aadityaa0523/HridayMitra/source_code/docs/DECISIONS.md

# HridayMitra: where we started, what changed, and why

## 1. Initial ideas → final product

| Stage | Idea | What happened |
|---|---|---|
| First idea | Wrist band + SMS | Dropped: a wrist cannot measure fluid in the legs or chest; elders forget to charge and wear bands |
| Explored | Ankle band, toe ring, stole pendant | Toe ring rejected (not worn by men); pendant kept, as the amulet |
| Rejected by the team | Vest, smart pillow | "No one will wear a vest"; the pillow did not suit rural homes or shared beds |
| Locked | Foldable **check-in stool** (weight, 8-electrode impedance, finger PPG, voice, buttons, SIM800L) + **Kavach amulet** + **SMS care loop** | Satisfies every PS requirement under ₹5,000 |
| Build guide v1 → v3 | v2 added hand electrodes (chest by segmental subtraction) and the INA126; v3 cut cost (one HX711 bridge, voice from flash, no boot pins) | v3 is the build reference |

## 2. Decisions taken during the build (most recent last)

| # | Decision | Why | Evidence |
|---|---|---|---|
| 1 | Pretend patients built on a hidden "congestion" number, with every parameter marked as published / LTspice / ASSUMPTION | No human data allowed; every number must be traceable | `data/processed/DATA.md` |
| 2 | Guest days 3% → 1% | Weight rule gave 3× the published false-alert rate; calibrated to published results | `reports/calibration_check.csv` |
| 3 | Thresholds tuned on training patients only, then frozen | Honest testing; judges check this | `engine/frozen_params_v2.json` |
| 4 | Engine v2 (T = 7 → 6.5) | +9 points sensitivity at the same false alerts | `reports/leadtime_v2_results.csv` |
| 5 | No slow-drift (CUSUM) detector | Gave 5–7 days lead but 5× the false-alert budget | `reports/leadtime_v2_grid.csv` |
| 6 | Amber = patient-only "check again"; red = SMS | Amber gives 4 days' notice but fires 1–2× a month; only red should reach the family | `reports/amber_lead_results.csv` |
| 7 | ASHA always told at 2 h unless the family replies "fine" | First design left 14% of alerts never reviewed; now 6% | `reports/careloop_results.csv` |
| 8 | Care-loop ladder: family 1 → family 2 (30 min) → ASHA (2 h) → PHC doctor (6 h) | Best simulated result (92% reviewed before the visit); replaces the older product-brief version | `sim/careloop/careloop.py` |
| 9 | **R8/R9 bias resistors 1 MΩ → 10 MΩ** | Monte Carlo of 100 cheap-part stools: 1 MΩ gave up to 12% error and an unusable chest reading; 10 MΩ: 99% within 2% | `sim/circuit/montecarlo.py` |
| 10 | Firmware reads impedance with a Goertzel filter, never peak-to-peak; measure on battery | Mains hum: peak-to-peak 18% wrong with a charger; Goertzel ≤ 0.17% | `sim/circuit/hum.py` |
| 11 | Toe-ring / plate check in the engine (> 25% jump → "no reading") | LTspice showed a ring bridging plates reads 58–86% high | `tests/test_alert_engine.py` |
| 12 | Amulet radio: **Bluetooth Low Energy**, summary in the advertisement (no pairing) | Built into both ESP32s (₹0), low power, works offline, nothing to pair for elders | `firmware/hridaymitra_amulet/` |
| 13 | Cost counted as build cost only (no shipping) | Team decision | `tools/cost_sim.py` |
| 14 | Engine runs **on the ESP32** (C++ port), the laptop only logs and shows | PS demands offline operation; proven identical to Python (100% of 3,231 days) | `tests/test_engine_parity.py` |
| 15 | "No check-in today" now holds yesterday's light; new "still learning" state for the first ~10 days | Found a gap: the no-data path never fired; cold start was silent | `engine/alert_engine.py` |
| 16 | Keep the rule engine, not machine learning, as the main decider | Logistic regression catches 6–12 points more but with 3–5× the false alarms; rules explain themselves and run in 7 KB | `reports/ml_comparator.csv` |
| 17 | Voice prompts from Windows' offline speech engine for now; recorded human clips override them | Gives working audio today; Hindi/Tamil need a human voice | `tools/make_voice_clips.py` |
| 18 | Missed days on the stool detected from the SIM800L network clock | No RTC on the board; keeps the history true | `clockNow()` in the stool firmware |
| 19 | **Product layer** around the engine (lights unchanged, so all frozen results stay valid): doctor's sick-day plan, coaching tips, two users per stool, daily self-test with service SMS, 11:00 missed check-in reminder, Sunday ASHA summary, village dashboard, OPD report, ABDM/FHIR export | Another team also built a chair; the difference has to be the product around it | `engine/product.py`, `tests/test_product.py`, firmware `duties()` |
| 20 | Seat vibration motor on GPIO19 (₹40) and tablet-drawer switch on GPIO36 (₹25); AD8232 LO− dropped to free GPIO36 | Hearing loss is common in elders; medicine adherence is measured instead of asked. Build cost now ₹4,243–4,397 | `tools/make_schematic.py` (ERC 0), build guide v3 section 4 |
| 21 | Battery level and signal strength read from the SIM800L (AT+CBC, AT+CSQ) | No free analog pin needed for the self-test | `selfTest()` |
| 32 | **Sit-to-stand from the platform's force** (the chair now stands on the weighing platform, so the weight never leaves it): the force above / below body weight is the body's vertical acceleration; integrated twice it is the rise itself. A minimum-jerk rise + slow drift is fitted (start, duration, height); not a stand if the height is outside 0.12-0.65 m or the fit is poor. No new parts | Synthetic rises (different motion model: skewed, forward-lean dip, sway, HX711 noise, 10 S/s), 40-100 kg, 1-4.5 s: 100 % found, median error 0.14 s (0.07 s fast, 0.16 s slow), 0 false stands while seated; C++ = Python; firmware emulator 2.20 s for a 2.2 s rise | `engine/sts.py`, `tests/test_sts.py`, `hm::stsFit` |
| 31 | **Hybrid engine: rules propose, ML confirms** (`engine/hybrid.py`): rules at T 4.0, a logistic model (13 weights, trained on dev only) must agree before red; SpO2 danger always red; reasons stay the rules' | Benchmark v2, frozen before testing: caught 86 % on test, external and stress (rules v3: 66 / 72 / 63 %, ML only: 80 / 81 / 77 %), false alerts 0.19 / 0.09 / 0.19 per patient-month (budget 0.21). Runs on the laptop and app; the stool still runs rules v3 | `benchmark/LEADERBOARD.md`, `tests/test_benchmark.py` |
| 30 | **Open benchmark v2** (`benchmark/`): fixed dev / test / external / stress splits with sha256, a public scorer with bootstrap ranges, 5 baselines, datasheet | Anyone can score a method the same way; our numbers are reproducible | `benchmark/README.md` |
| 29 | **Calibration against published trials**: FAST and SCALE-HF 1 weight rules applied exactly as defined | External cohort: 20 % caught vs 23 % published (FAST), 33 % vs 35 % (SCALE-HF 1); unexplained alerts 4.8 vs 4.3 and 4.85 vs 4.18 per patient-year. The 60-day PS cohort catches the same share but has ~7 false alerts per year (harsher than the trials) | `engine/calibrate_published.py` |
| 28 | **CHARGE / USE switch** (SW6, DPDT, +₹50): USE cuts both USB wires; CHARGE is sensed on GPIO39 (moved off the optional ECG LO+) and the firmware refuses to measure | Charger leakage through an earthed patient: 339 µA with a cheap charger (limit 100 µA), 72 mA with a failed one; with the switch on USE 0.19 µA in every case. Total still ₹4,820, ₹180 under the limit | `sim/circuit/charger_leakage.py`, `tests/sil`, `tools/make_schematic.py` netlist checks |
| 27 | **6-minute walk test on the amulet** (no new parts): steps from the walking rhythm (autocorrelation of 5 s windows at 20 Hz), best 6 minutes in the last 24 h sent over BLE; the stool asks for the walk on Sundays and the weekly SMS gives steps, ~metres (STEP_LENGTH_M, set once over 10 m) and last week. Reported to the ASHA/doctor, **not** in the alert score: it has no validated weight yet, and adding it would change the frozen engine | Synthetic: snug cord within 2.7% at 60-120 steps/min and 0.05-0.3 g steps; loose cord within 4% at normal steps, up to 23% under with very light steps. 0 false steps in 30 min each of sitting, fidgeting, auto-rickshaw ride, turning in bed. C++ = Python | `engine/walk_accuracy.py`, `tests/test_walk.py`, `tests/sil` |
| 26 | **Self-calibrating reference**: R5 → 120 Ω + Rcal 100 Ω 0.1% (+₹10); the spare 74HC4053 switch on GPIO12 makes every reading relative to the precision resistor and checks the (R5 + Rcal)/Rcal = 2.2 ratio at each check-in | Monte Carlo absolute error median 0.77% → 0.16%, 99% of readings 1.96% → 1.32%. A damaged or wrongly built reference is caught and the stool sends a service SMS instead of numbers (firmware emulator) | `sim/circuit/selfcal.py`, `sim/circuit/montecarlo.py`, `tests/sil` |
| 25 | **Patient-safety fault analysis (IEC 60601-1, type BF)** before building | Every single fault passes with ≥ 12.8× margin (6.6× in normal use); the two series capacitors block DC. No circuit change needed; a "Charge / Use" switch is recommended | `sim/circuit/safety.py` |
| 24 | **Bioimpedance spectroscopy (5/20/50 kHz) + engine v3**: the legs are measured at three frequencies; an exact closed-form Cole fit on the ESP32 gives the share of water outside the cells; ADC streamed by DMA at 200 kS/s (analogRead is too slow for 50 kHz); C5 unchanged | LTspice: +10% fluid outside cells → index +3.0%, foot position/temperature +3% → index 0.0% (single-frequency reading +3.0%), fluid inside cells → index −2.9%. Engine v3 (threshold re-tuned on training patients, frozen at 7.0): external cohort 65% → 72% sensitivity at the same false alerts; held-out: same sensitivity, lead 2 → 3 days, false alerts 0.03 → 0.06 | `sim/circuit/spectroscopy.py`, `engine/bis.py`, `engine/tune_v3.py`, `reports/v3_results.csv` |
| 23 | **Wokwi with three custom chips**: virtual patient with an 8-electrode front end (sliders: leg/chest fluid, lifted foot, hum), MAX30102 (pulse, SpO₂, finger), SIM800L with a phone screen (replies, missed call, outage, battery) | Wokwi has none of these parts; judges can make the virtual patient sick and watch the real firmware react. Production firmware builds with `HM_WOKWI` (no BLE, 1 s = 1 min, 20 days preloaded) | `wokwi/`, `tools/make_wokwi.py` |
| 22 | **Software-in-the-loop proof**: the real firmware is compiled on a laptop against an emulated world (body impedance through the ADC, HX711 bits, MAX30102 FIFO, SIM800L AT commands, buttons, BLE, flash) and lives a scripted month | No boards yet; this proves the firmware's logic end to end. It found 3 real bugs, now fixed: user 1's usual weight started at 0 kg; a red day could pass with no SMS after an earlier red; user 1 was not recognised once a second user was enrolled. Also fixed a rare lost-reply race | `tests/sil/`, `tests/test_firmware_sil.py`, `reports/sil_run.log` |

## 3. Where it can still improve (after the hackathon)

1. **Bench build vs simulation**: build the resistor phantom and the stool, compare with LTspice (the biggest open risk).
2. **Real voices**: record Hindi and Tamil prompts (drop WAVs into `firmware/voice/hi/`, run `python tools/make_voice_clips.py --lang hi`).
3. **SpO₂ calibration** against a reference oximeter (the formula is generic).
4. **Hybrid engine**: add learned weights (logistic regression) inside the two-witness rules, aiming for its +6–12 points without its false alarms.
5. **Lead time**: a trend detector that respects the alert budget (the drift detector gave 5–7 days but too many alarms).
6. **A ₹100 real-time clock (DS3231)** so missed days are known even without network time.
7. **Amulet**: validate breathing and sit-up detection on a breathing phantom or recorded motion data; tune the fall threshold.
8. **Clinical pilot** (ethics-approved): compare the chest reading with lung ultrasound B-lines; refit the alert threshold on real data.
9. **Wokwi** simulation of the firmware's check-in flow (optional, for the demo).
10. **Hardware**: a printed circuit board from the KiCad schematic, stainless-steel plates, and a splash-proof enclosure.
