aadityaa0523/HridayMitra/source_code/docs/hardware/frontend_sheet.pdf

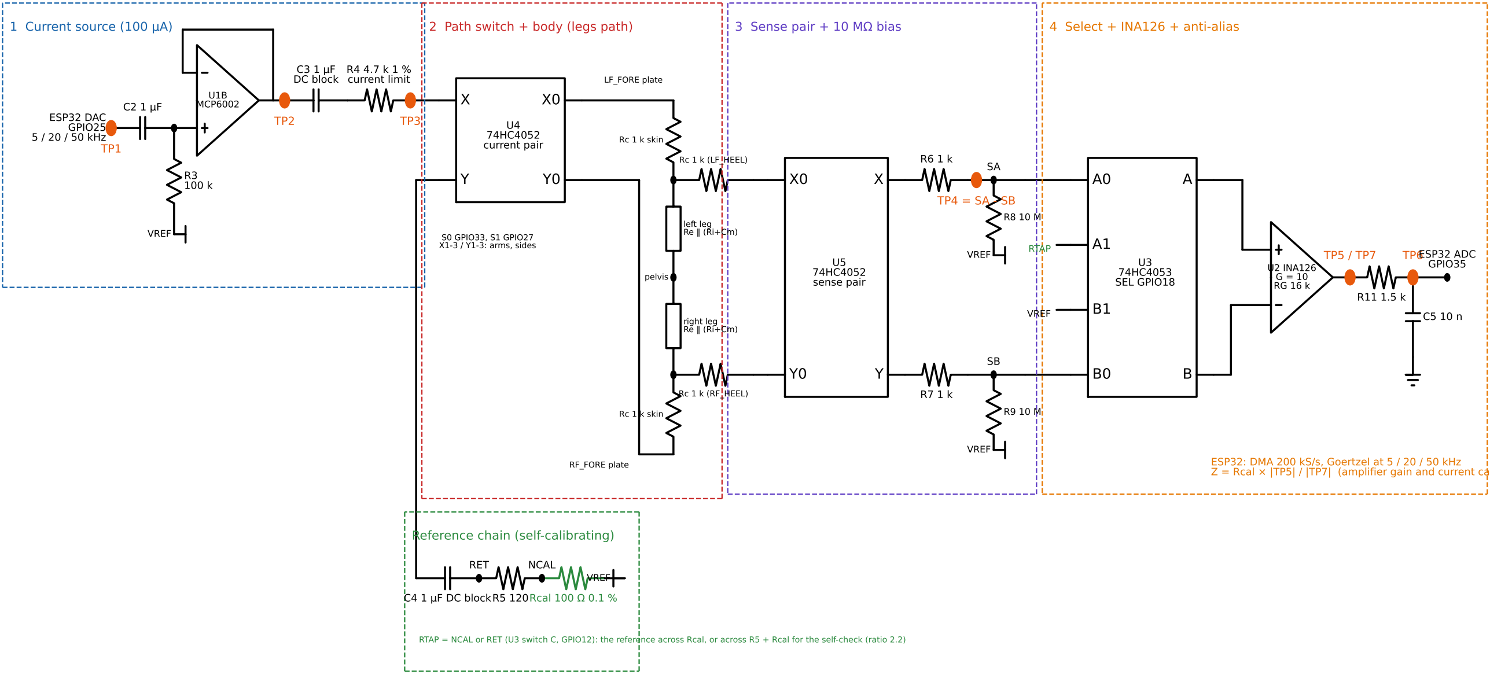
[picture p24: figure]
VREF; U1B MCP6002; C3 1 µF DC block; R4 4.7 k 1 % current limit; U4 74HC4052 current pair; S0 GPIO33, S1 GPIO27 X1-3 / Y1-3: arms, sides; LF_FORE plate; Rc 1 k skin; left leg; right leg; k skin; RF_FORE plate; C4 1 µF DC blockR5 120Rcal 100; Rc 1 k (LF_HEEL); Rc 1 k (RF_HEEL); U5 74HC4052 sense pair; U3 74HC4053 SEL GPIO18; RTAP; U2 INA126 G = 10 RG 16 k; Reference chain (self-calibrating); ESP32 DAC GPIO25 5 / 20 / 50 kHz TP1; pelvis; RET; NCAL; TP6ESP32 ADC; GPIO35

RTAP = NCAL or RET (U3 switch C, GPIO12): the reference across Rcal, or across R5 + Rcal for the self-check (ratio 2.2)

ESP32: DMA 200 kS/s, Goertzel at 5 / 20 / 50 kHz
Z = Rcal × |TP5| / |TP7| (amplifier gain and current cancel)
1 Current source (100 µA) | 2 Path switch + body (legs path)
3 Sense pair + 10 M bias | 4 Select + INA126 + anti-alias
Patient safety (IEC 60601-1 type BF, LTspice): C3 and C4 in series block DC; R4 limits the current; every single fault stays | 12.8× under the limit. CHARGE / USE switch (SW6) cuts both charger wires while measuring: leakage 0.19 µA instead of 339 µA.
0.0 | 0.5 | 1.0 | 1.5 | 2.0
ms

0.75

1.00

1.25

1.50

1.75

2.00

2.25

2.50

V

±0.83 V

TP1 DAC out

0.0 | 0.5 | 1.0 | 1.5 | 2.0
ms

0.75

1.00

1.25

1.50

1.75

2.00

2.25

2.50

V

±0.83 V

TP2 buffer out

0.0 | 0.5 | 1.0 | 1.5 | 2.0
ms

100

50

0

50

100

µA

±108 µA

TP3 current through the body

0.0 | 0.5 | 1.0 | 1.5 | 2.0
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
±62.3 mV

TP4 voltage across the legs

0.0 | 0.5 | 1.0 | 1.5 | 2.0
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
±0.623 V

TP5 INA126 out (body)

0.0 | 0.5 | 1.0 | 1.5 | 2.0
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
±0.564 V

TP6 ADC pin

0.0 | 0.5 | 1.0 | 1.5 | 2.0
ms

1.55

1.60

1.65

1.70

1.75

V

±0.108 V

TP7 INA126 out (Rcal)

# HridayMitra custom hardware: 8-electrode bioimpedance front end + ESP32 (legs path shown)

Bottom row: LTspice at each test point (legs path, 5 kHz, 1 k skin contacts). Result: Z = 578.4 (exact 578.5 ). Same values as the KiCad schematic (ERC 0) and the LTspice netlists. Monitoring, not diagnosis.
