aadityaa0523/HridayMitra/source_code/docs/HridayMitra user journey.pdf

U S ER J O U R N E Y · H M - U X- 0 0 1 · O N E M O N T H , O N E FA M I LY

# A month with HridayMitra: Ramesh's story

Who uses it, when, for how long, and why they keep using it for months. Every light, score and reason below is the real output of our frozen engine on synthetic patient P0189 from the held-out test set. The people are fictional; no human data was collected.

# 90 s

a day for Ramesh, sitting
down

0

reading, typing, apps or
charging for him

# 4 days

of warning for him
(median 3 on test
patients)

₹4,890

home unit parts, under
the ₹5,000 limit

## Ramesh, 62 · the patient

Heart failure, home after a hospital stay. Retired farmer, speaks Hindi, reads little, no smartphone.

### 90 s a day · about 45 min a month

## Sunita · family member 1

His daughter-in-law. Gets HridayMitra's SMS on a basic phone; replies 1 / 2 / 3 or a missed call.
a few seconds, only when it matters

## Kamla · ASHA worker

Sets up the platform and lap bar, gets a one-line Sunday SMS per patient, visits on red. Fits the home visits she already makes.

### 10 min once · then on red alerts

## Dr. Meena · PHC doctor

Writes his amber / red plan once; it lives on the device. Called only if nobody has examined him within 6 hours.

### 5 min once · rare calls

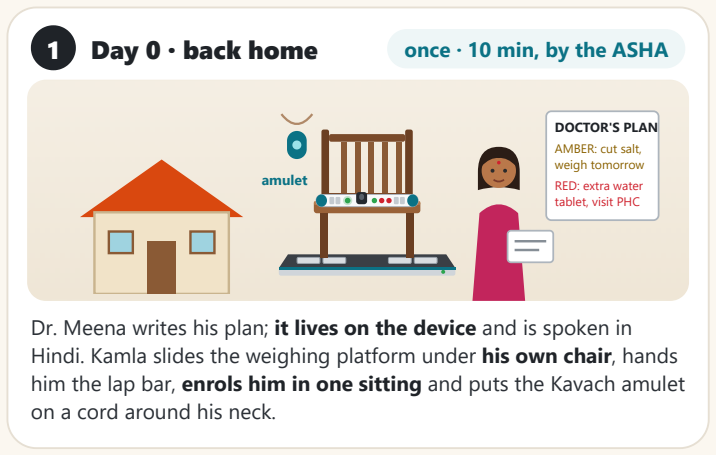
[picture p25: figure]
on a cord around his neck.; DOCTOR'S PLAN AMBER: cut salt, weigh tomorrow RED: extra water tablet, visit PHC; amulet
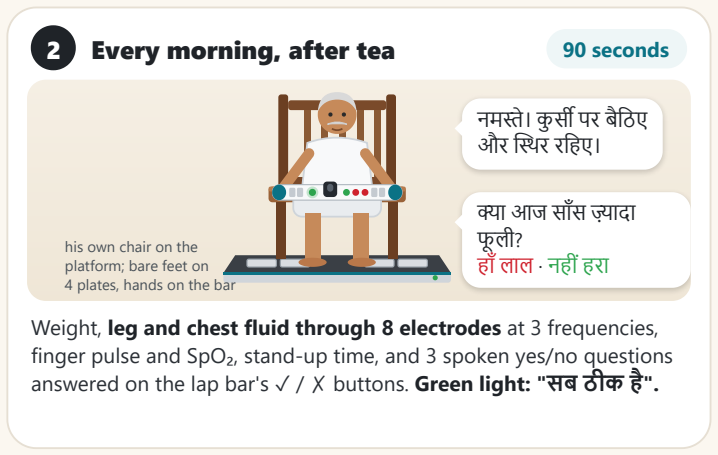
[picture p26: figure]
2 Every morning, after tea; 90 seconds; his own chair on the platform; bare feet on 4 plates, hands on the bar; नमस्ते। कुर्सी पर बैठिए और स्थिर रहिए।
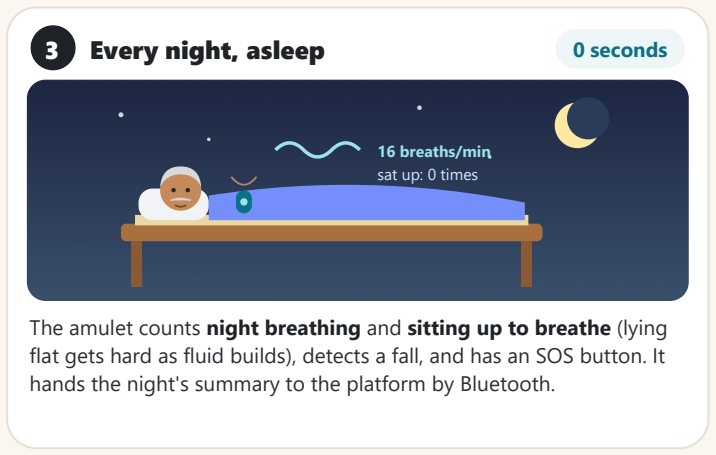
[picture p27: figure]
3 Every night, asleep; 0 seconds; 16 breaths/min sat up: 0 times
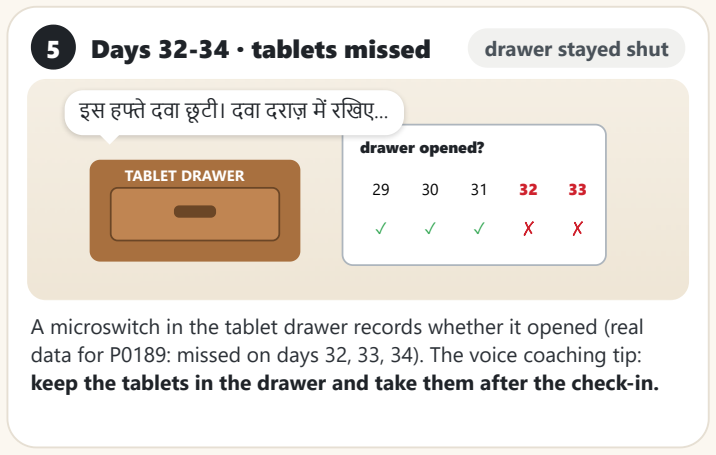
[picture p28: figure]
TABLET DRAWER; drawer opened?
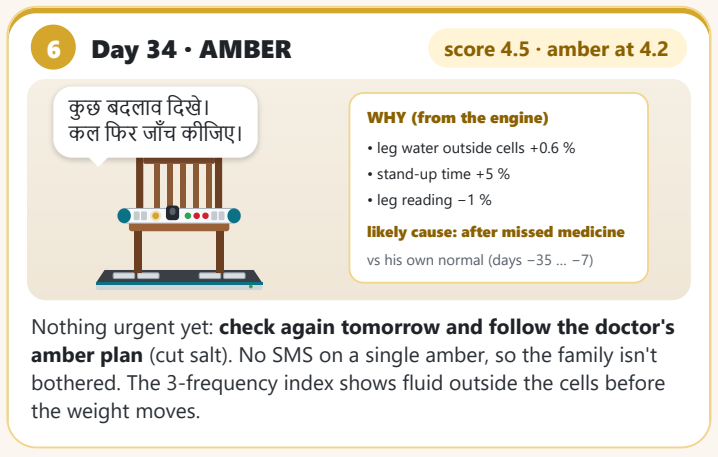
[picture p29: figure]
the weight moves.; WHY (from the engine); • leg water outside cells +0.6 % • stand-up time +5 % • leg reading −1 %; likely cause: after missed medicine vs his own normal (days −35 … −7); कुछ बदलाव दिखे। कल फिर जाँच कीजिए।
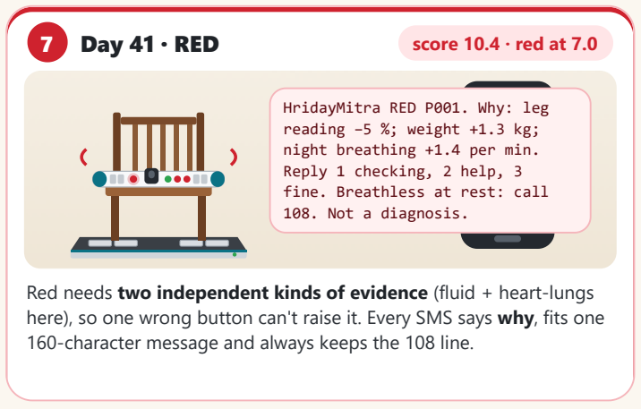
[picture p30: figure]
7 Day 41 · RED; score 10.4 · red at 7.0; HridayMitra RED P001. Why: leg reading −5 %; weight +1.3 kg; night breathing +1.4 per min. Reply 1 checking, 2 help, 3 fine. Breathless at rest: call 108. Not a diagnosis.
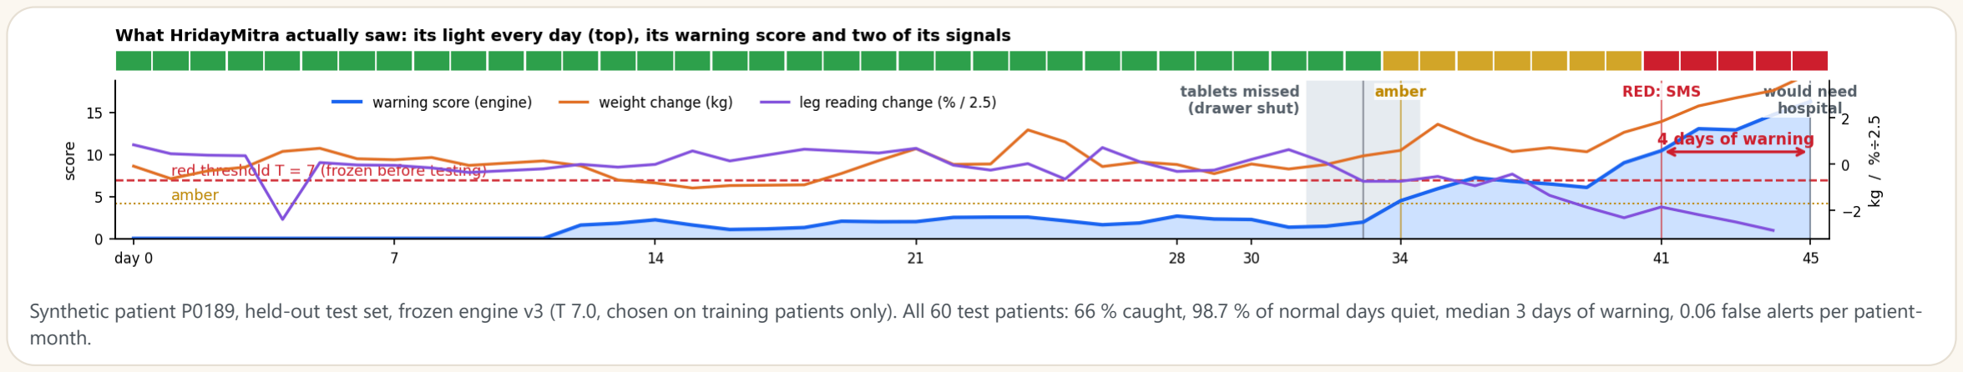
[picture p31: figure]
month.

Synthetic patient P0189, held-out test set, frozen engine v3 (T 7.0, chosen on training patients only). All 60 test patients: 66 % caught, 98.7 % of normal days quiet, median 3 days of warning, 0.06 false alerts per patient-

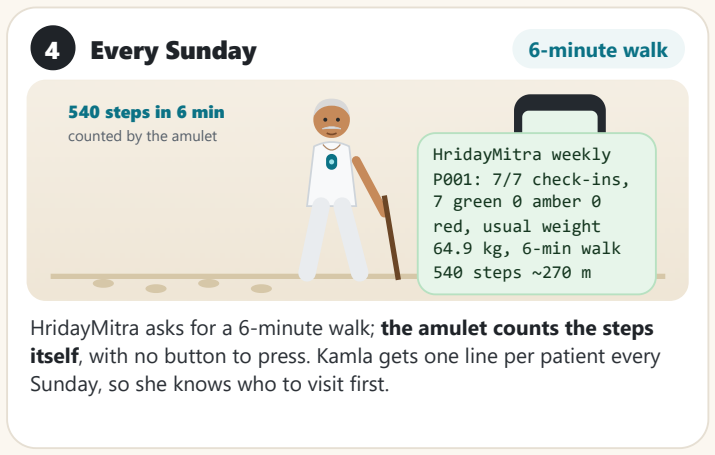
[picture p32: figure]
4 Every Sunday; 6-minute walk; 540 steps in 6 min counted by the amulet; HridayMitra weekly P001: 7/7 check-ins, 7 green 0 amber 0 red, usual weight 64.9 kg, 6-min walk 540 steps ~270 m
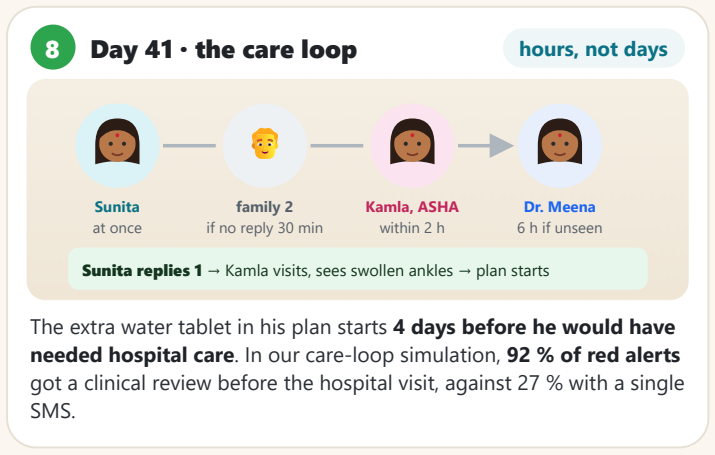
[picture p33: figure]
SMS.; Sunita at once; family 2 if no reply 30 min; Kamla, ASHA within 2 h; Dr. Meena 6 h if unseen

### WHEN THINGS GO WRONG

Power cut | Runs on its battery; SMS wait in a queue.
No network | Light and voice still work; SMS retried every 10 min.
Guest sits down | Weight and legs don't match him: nothing saved.
Foot off a plate | "Your left foot is not touching its plate", then re-measured.
Fever, not fluid | Pulse up, fluid steady: "maybe an infection, see the doctor".
Skipped a day | No check-in by 11 am: reminder SMS to the family.
Pacemaker / ICD | Never on the plates: weight-only mode.

Why Ramesh is still using it in month 6 the PS asks: why will they keep using it for months?

1 Day 0 · back home | once · 10 min, by the ASHA

Dr. Meena writes his plan; it lives on the device and is spoken in Hindi. Kamla slides the weighing platform under his own chair, hands him the lap bar, enrols him in one sitting and puts the Kavach amulet

Weight, leg and chest fluid through 8 electrodes at 3 frequencies, finger pulse and SpO₂, stand-up time, and 3 spoken yes/no questions answered on the lap bar's ✓ / ✗ buttons. Green light: "सब ठी क है".

The amulet counts night breathing and sitting up to breathe (lying flat gets hard as fluid builds), detects a fall, and has an SOS button. It hands the night's summary to the platform by Bluetooth.

HridayMitra asks for a 6-minute walk; the amulet counts the steps itself, with no button to press. Kamla gets one line per patient every Sunday, so she knows who to visit first.

### 5 Days 32-34 · tablets missed drawer stayed shut

A microswitch in the tablet drawer records whether it opened (real data for P0189: missed on days 32, 33, 34). The voice coaching tip: keep the tablets in the drawer and take them after the check-in.

6 Day 34 · AMBER | score 4.5 · amber at 4.2

Nothing urgent yet: check again tomorrow and follow the doctor's amber plan (cut salt). No SMS on a single amber, so the family isn't bothered. The 3-frequency index shows fluid outside the cells before

Red needs two independent kinds of evidence (fluid + heart-lungs here), so one wrong button can't raise it. Every SMS says why, fits one 160-character message and always keeps the 108 line.

8 Day 41 · the care loop | hours, not days

The extra water tablet in his plan starts 4 days before he would have needed hospital care. In our care-loop simulation, 92 % of red alerts got a clinical review before the hospital visit, against 27 % with a single

Sunita replies 1 → Kamla visits, sees swollen ankles → plan starts

HABIT

### Tied to tea and tablets

Same seat, same time, right next to the tablet drawer. A habit he already has, not a new one.

EFFORT

### 90 s, sitting down

No patch on the skin, nothing to read, type, pair or charge. The platform charges overnight on CHARGE.

TRUST

### Learns his normal

Compared only with his own days 35 to 7 ago. 0.06 false alerts a month, so nobody learns to ignore it.

CARE

### It talks back

Hindi voice, his doctor's words, tips on salt and tablets, and a green "सब ठी क है" most days.

ASHA

### Fits her rounds

Sunday summary + red alerts tell Kamla whom to visit first: less guessing, same visits.

FAMILY

### Peace of mind

Sunita hears only when it matters, with the reason. The Saathi app shows the month for whoever wants more.

Monitoring, not diagnosis. Synthetic data only; no human data collected. Never used on anyone with a pacemaker or ICD. | HridayMitra · Transfinitte 2026 hardware track · github.com/aadityaa0523/HridayMitra
