aadityaa0523/HridayMitra/source_code/docs/demo/hridaymitra_month_demo_poster.png

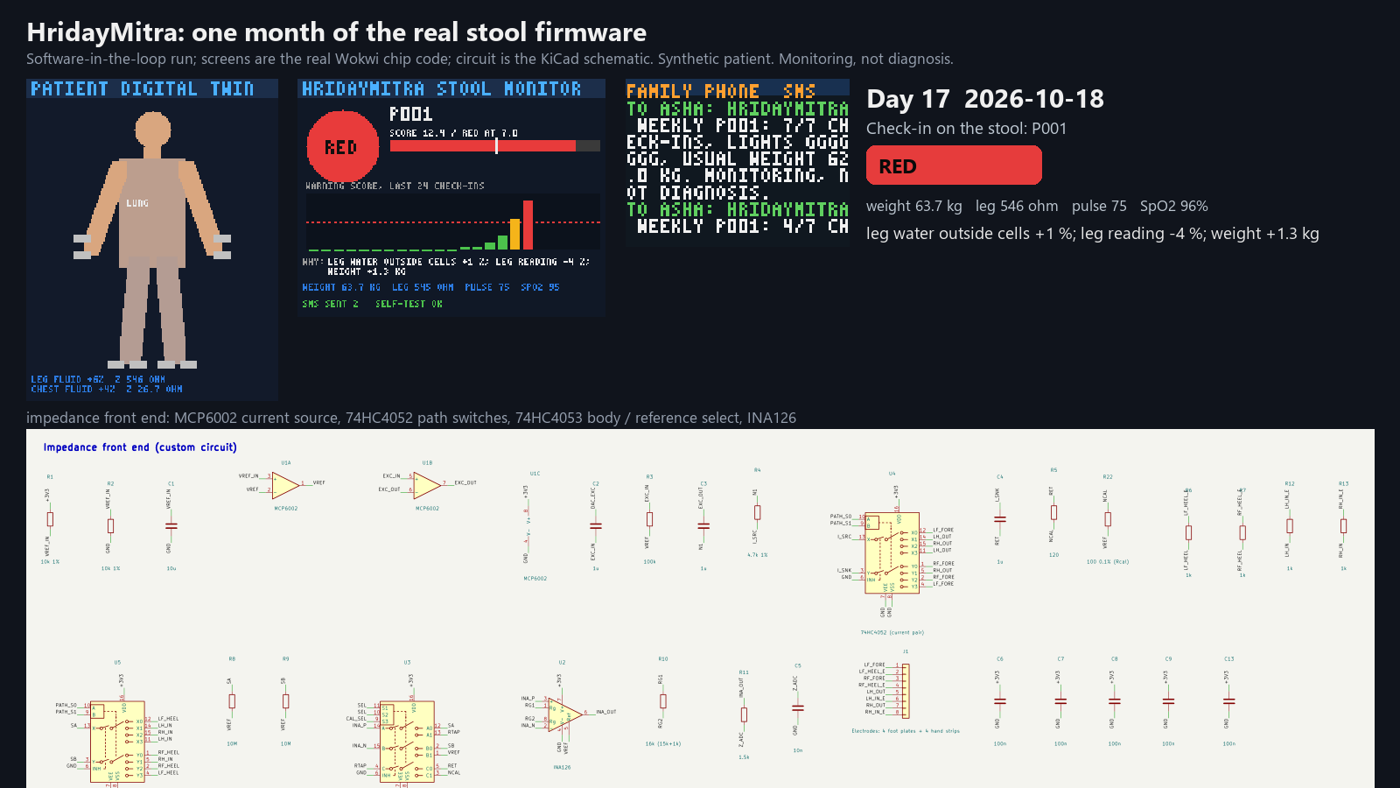
source_code/docs/demo/hridaymitra_month_demo_poster.png
