aadityaa0523/HridayMitra/source_code/docs/hardware/architecture.png

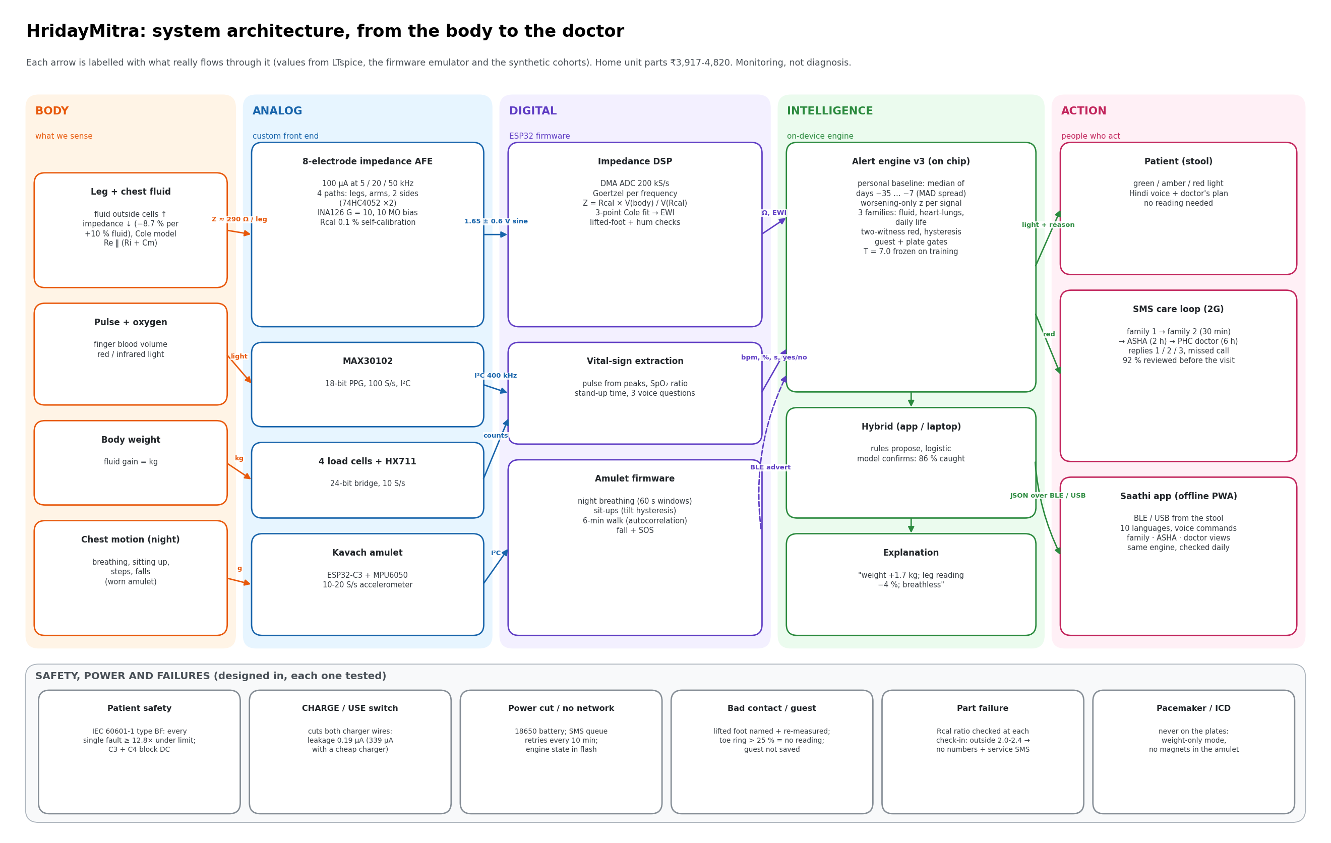
source_code/docs/hardware/architecture.png
