aadityaa0523/HridayMitra/source_code/docs/hardware/HM-HW-004_pcb_3d_bottom.png

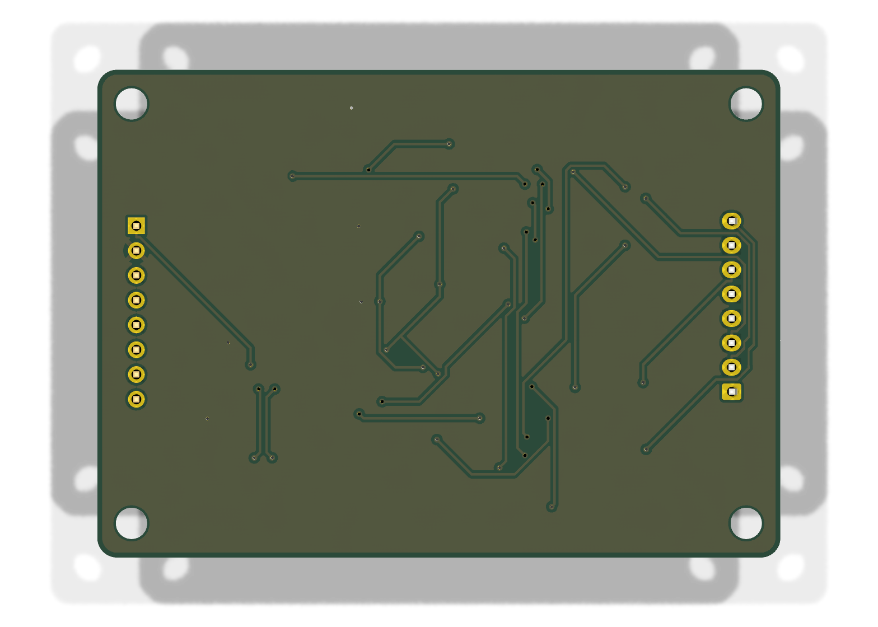
source_code/docs/hardware/HM-HW-004_pcb_3d_bottom.png
