aadityaa0523/HridayMitra/source_code/docs/journey/chart.png

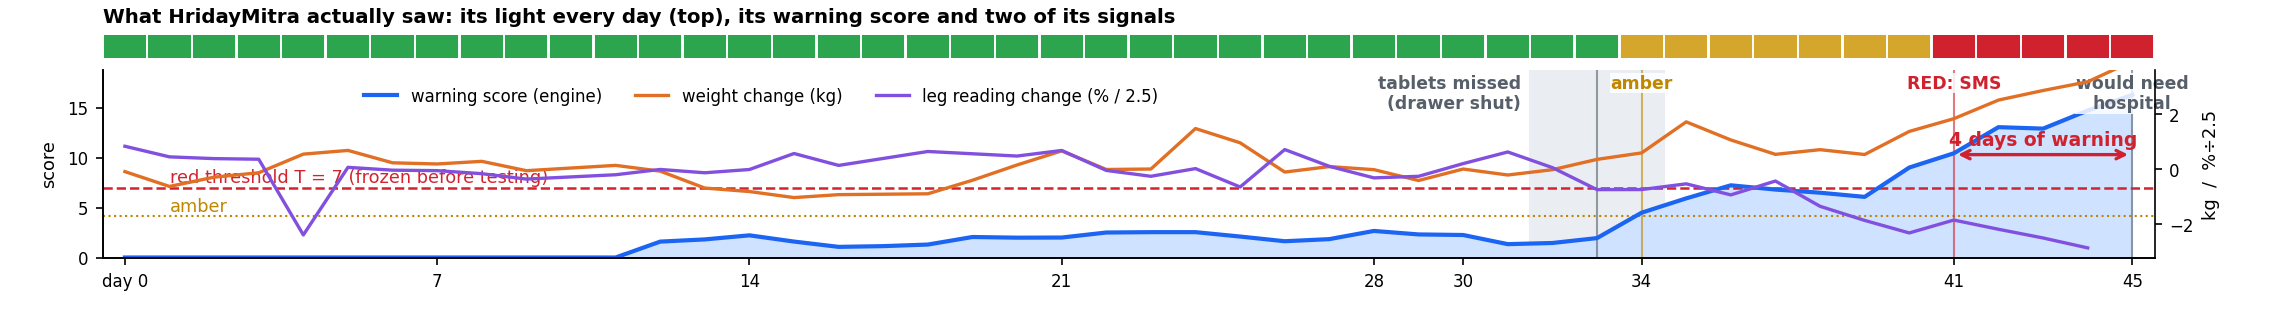
source_code/docs/journey/chart.png
