aadityaa0523/HridayMitra/source_code/reports/bp1.png

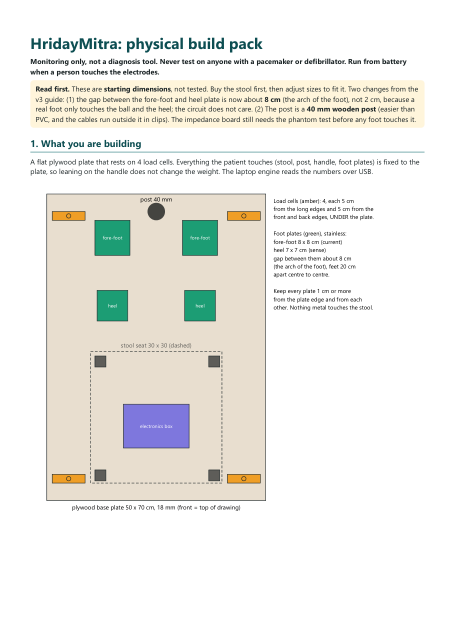
source_code/reports/bp1.png
