aadityaa0523/HridayMitra/source_code/reports/bp2.png

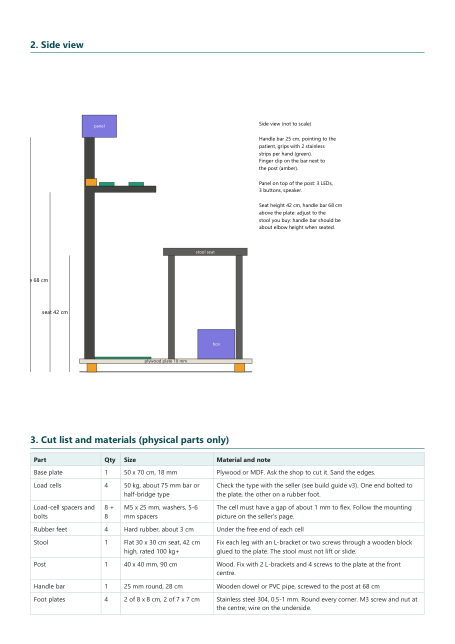
source_code/reports/bp2.png
