aadityaa0523/HridayMitra/source_code/reports/wg1.png

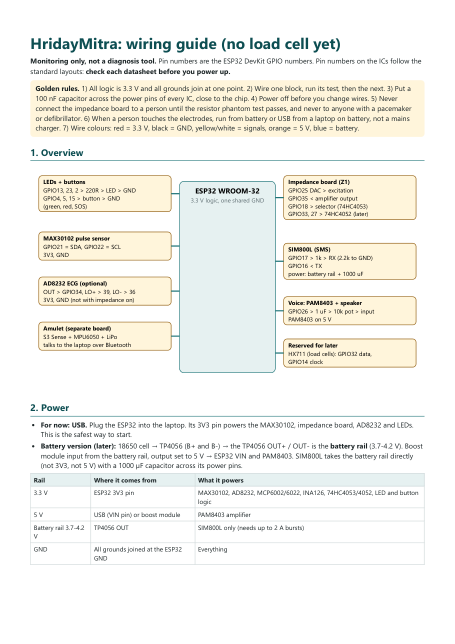
source_code/reports/wg1.png
