aadityaa0523/HridayMitra/source_code/reports/wokwi_chip_screens_preview.png

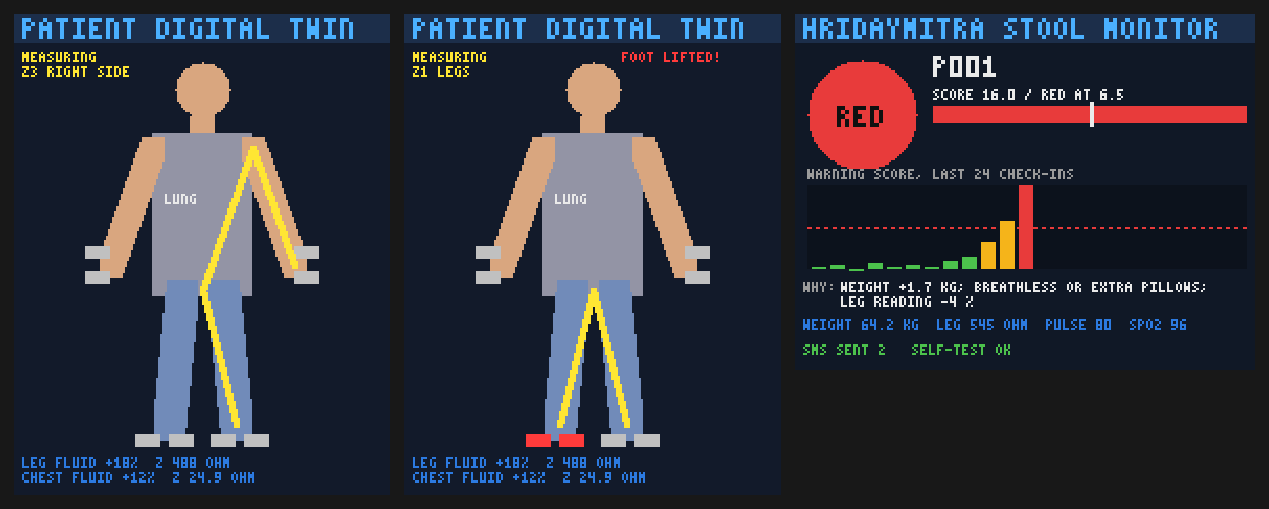
source_code/reports/wokwi_chip_screens_preview.png
