aadityaa0523/HridayMitra/01_Hardware_Design/cost_report.pdf

# HridayMitra home unit: cost report

₹4,402

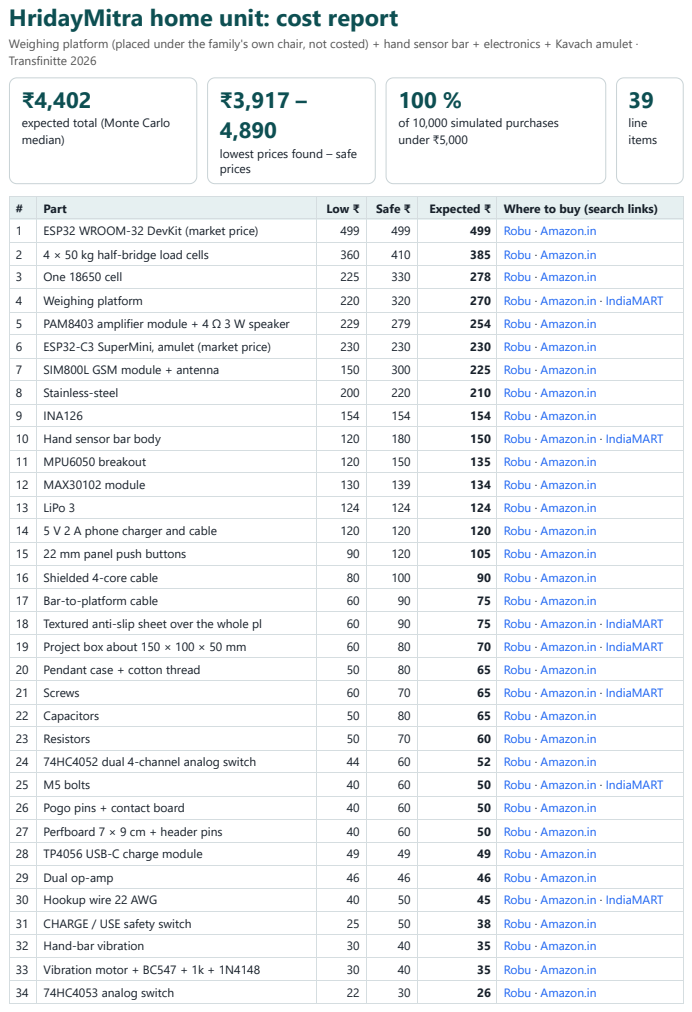
[picture p44: page 1]
line items

Weighing platform (placed under the family's own chair, not costed) + hand sensor bar + electronics + Kavach amulet ·
Transfinitte 2026

expected total (Monte Carlo
median)

of 10,000 simulated purchases
under ₹5,000

lowest prices found – safe
prices

# | Part | Low ₹ | Safe ₹ | Expected ₹ | Where to buy (search links)
1 | ESP32 WROOM-32 DevKit (market price) | 499 | 499 | 499 | Robu (https://robu.in/?s=ESP32+DevKit+V1+WROOM-32&post_type=product) · Amazon.in (https://www.amazon.in/s?k=ESP32+DevKit+V1+WROOM-32)
2 | 4 × 50 kg half-bridge load cells | 360 | 410 | 385 | Robu (https://robu.in/?s=4+x+50+kg+half-bridge+load+cells&post_type=product) · Amazon.in (https://www.amazon.in/s?k=4+x+50+kg+half-bridge+load+cells)
3 | One 18650 cell | 225 | 330 | 278 | Robu (https://robu.in/?s=One+18650+cell&post_type=product) · Amazon.in (https://www.amazon.in/s?k=One+18650+cell)
4 | Weighing platform | 220 | 320 | 270 | Robu (https://robu.in/?s=Weighing+platform&post_type=product) · Amazon.in (https://www.amazon.in/s?k=Weighing+platform) · IndiaMART (https://dir.indiamart.com/search.mp?ss=Weighing+platform)
5 | PAM8403 amplifier module + 4 Ω 3 W speaker | 229 | 279 | 254 | Robu (https://robu.in/?s=PAM8403+amplifier+module+%2B+4+%CE%A9+3+W+speaker&post_type=product) · Amazon.in (https://www.amazon.in/s?k=PAM8403+amplifier+module+%2B+4+%CE%A9+3+W+speaker)
6 | ESP32-C3 SuperMini, amulet (market price) | 230 | 230 | 230 | Robu (https://robu.in/?s=ESP32-C3+SuperMini&post_type=product) · Amazon.in (https://www.amazon.in/s?k=ESP32-C3+SuperMini)
7 | SIM800L GSM module + antenna | 150 | 300 | 225 | Robu (https://robu.in/?s=SIM800L+GSM+module+%2B+antenna&post_type=product) · Amazon.in (https://www.amazon.in/s?k=SIM800L+GSM+module+%2B+antenna)
8 | Stainless-steel | 200 | 220 | 210 | Robu (https://robu.in/?s=Stainless-steel&post_type=product) · Amazon.in (https://www.amazon.in/s?k=Stainless-steel)
9 | INA126 | 154 | 154 | 154 | Robu (https://robu.in/?s=INA126&post_type=product) · Amazon.in (https://www.amazon.in/s?k=INA126)
10 | Hand sensor bar body | 120 | 180 | 150 | Robu (https://robu.in/?s=Hand+sensor+bar+body&post_type=product) · Amazon.in (https://www.amazon.in/s?k=Hand+sensor+bar+body) · IndiaMART (https://dir.indiamart.com/search.mp?ss=Hand+sensor+bar+body)
11 | MPU6050 breakout | 120 | 150 | 135 | Robu (https://robu.in/?s=MPU6050+breakout&post_type=product) · Amazon.in (https://www.amazon.in/s?k=MPU6050+breakout)
12 | MAX30102 module | 130 | 139 | 134 | Robu (https://robu.in/?s=MAX30102+module&post_type=product) · Amazon.in (https://www.amazon.in/s?k=MAX30102+module)
13 | LiPo 3 | 124 | 124 | 124 | Robu (https://robu.in/?s=LiPo+3&post_type=product) · Amazon.in (https://www.amazon.in/s?k=LiPo+3)
14 | 5 V 2 A phone charger and cable | 120 | 120 | 120 | Robu (https://robu.in/?s=5+V+2+A+phone+charger+and+cable&post_type=product) · Amazon.in (https://www.amazon.in/s?k=5+V+2+A+phone+charger+and+cable)
15 | 22 mm panel push buttons | 90 | 120 | 105 | Robu (https://robu.in/?s=22+mm+panel+push+buttons&post_type=product) · Amazon.in (https://www.amazon.in/s?k=22+mm+panel+push+buttons)
16 | Shielded 4-core cable | 80 | 100 | 90 | Robu (https://robu.in/?s=Shielded+4-core+cable&post_type=product) · Amazon.in (https://www.amazon.in/s?k=Shielded+4-core+cable)
17 | Bar-to-platform cable | 60 | 90 | 75 | Robu (https://robu.in/?s=Bar-to-platform+cable&post_type=product) · Amazon.in (https://www.amazon.in/s?k=Bar-to-platform+cable)
18 | Textured anti-slip sheet over the whole pl | 60 | 90 | 75 | Robu (https://robu.in/?s=Textured+anti-slip+sheet+over+the+whole+pl&post_type=product) · Amazon.in (https://www.amazon.in/s?k=Textured+anti-slip+sheet+over+the+whole+pl) · IndiaMART (https://dir.indiamart.com/search.mp?ss=Textured+anti-slip+sheet+over+the+whole+pl)
19 | Project box about 150 × 100 × 50 mm | 60 | 80 | 70 | Robu (https://robu.in/?s=Project+box+about+150+x+100+x+50+mm&post_type=product) · Amazon.in (https://www.amazon.in/s?k=Project+box+about+150+x+100+x+50+mm) · IndiaMART (https://dir.indiamart.com/search.mp?ss=Project+box+about+150+x+100+x+50+mm)
20 | Pendant case + cotton thread | 50 | 80 | 65 | Robu (https://robu.in/?s=Pendant+case+%2B+cotton+thread&post_type=product) · Amazon.in (https://www.amazon.in/s?k=Pendant+case+%2B+cotton+thread)
21 | Screws | 60 | 70 | 65 | Robu (https://robu.in/?s=Screws&post_type=product) · Amazon.in (https://www.amazon.in/s?k=Screws) · IndiaMART (https://dir.indiamart.com/search.mp?ss=Screws)
22 | Capacitors | 50 | 80 | 65 | Robu (https://robu.in/?s=Capacitors&post_type=product) · Amazon.in (https://www.amazon.in/s?k=Capacitors)
23 | Resistors | 50 | 70 | 60 | Robu (https://robu.in/?s=Resistors&post_type=product) · Amazon.in (https://www.amazon.in/s?k=Resistors)
24 | 74HC4052 dual 4-channel analog switch | 44 | 60 | 52 | Robu (https://robu.in/?s=74HC4052+dual+4-channel+analog+switch&post_type=product) · Amazon.in (https://www.amazon.in/s?k=74HC4052+dual+4-channel+analog+switch)
25 | M5 bolts | 40 | 60 | 50 | Robu (https://robu.in/?s=M5+bolts&post_type=product) · Amazon.in (https://www.amazon.in/s?k=M5+bolts) · IndiaMART (https://dir.indiamart.com/search.mp?ss=M5+bolts)
26 | Pogo pins + contact board | 40 | 60 | 50 | Robu (https://robu.in/?s=Pogo+pins+%2B+contact+board&post_type=product) · Amazon.in (https://www.amazon.in/s?k=Pogo+pins+%2B+contact+board)
27 | Perfboard 7 × 9 cm + header pins | 40 | 60 | 50 | Robu (https://robu.in/?s=Perfboard+7+x+9+cm+%2B+header+pins&post_type=product) · Amazon.in (https://www.amazon.in/s?k=Perfboard+7+x+9+cm+%2B+header+pins)
28 | TP4056 USB-C charge module | 49 | 49 | 49 | Robu (https://robu.in/?s=TP4056+USB-C+charge+module&post_type=product) · Amazon.in (https://www.amazon.in/s?k=TP4056+USB-C+charge+module)
29 | Dual op-amp | 46 | 46 | 46 | Robu (https://robu.in/?s=Dual+op-amp&post_type=product) · Amazon.in (https://www.amazon.in/s?k=Dual+op-amp)
30 | Hookup wire 22 AWG | 40 | 50 | 45 | Robu (https://robu.in/?s=Hookup+wire+22+AWG&post_type=product) · Amazon.in (https://www.amazon.in/s?k=Hookup+wire+22+AWG) · IndiaMART (https://dir.indiamart.com/search.mp?ss=Hookup+wire+22+AWG)
31 | CHARGE / USE safety switch | 25 | 50 | 38 | Robu (https://robu.in/?s=CHARGE+%2F+USE+safety+switch&post_type=product) · Amazon.in (https://www.amazon.in/s?k=CHARGE+%2F+USE+safety+switch)
32 | Hand-bar vibration | 30 | 40 | 35 | Robu (https://robu.in/?s=Hand-bar+vibration&post_type=product) · Amazon.in (https://www.amazon.in/s?k=Hand-bar+vibration)
33 | Vibration motor + BC547 + 1k + 1N4148 | 30 | 40 | 35 | Robu (https://robu.in/?s=Vibration+motor+%2B+BC547+%2B+1k+%2B+1N4148&post_type=product) · Amazon.in (https://www.amazon.in/s?k=Vibration+motor+%2B+BC547+%2B+1k+%2B+1N4148)
34 | 74HC4053 analog switch | 22 | 30 | 26 | Robu (https://robu.in/?s=74HC4053+analog+switch&post_type=product) · Amazon.in (https://www.amazon.in/s?k=74HC4053+analog+switch)

35 | Rubber feet | 20 | 30 | 25 | Robu (https://robu.in/?s=Rubber+feet&post_type=product) · Amazon.in (https://www.amazon.in/s?k=Rubber+feet) · IndiaMART (https://dir.indiamart.com/search.mp?ss=Rubber+feet)
36 | DIP sockets | 15 | 25 | 20 | Robu (https://robu.in/?s=DIP+sockets&post_type=product) · Amazon.in (https://www.amazon.in/s?k=DIP+sockets)
37 | Tablet drawer | 15 | 25 | 20 | Robu (https://robu.in/?s=Tablet+drawer&post_type=product) · Amazon.in (https://www.amazon.in/s?k=Tablet+drawer)
38 | LEDs 5 mm | 10 | 15 | 12 | Robu (https://robu.in/?s=LEDs+5+mm&post_type=product) · Amazon.in (https://www.amazon.in/s?k=LEDs+5+mm)
39 | Diodes | 10 | 15 | 12 | Robu (https://robu.in/?s=Diodes&post_type=product) · Amazon.in (https://www.amazon.in/s?k=Diodes)
| Total | 3,917 | 4,890 | 4,404 | Monte Carlo median ₹4,402
