aadityaa0523/HridayMitra/03_Data/1_main_200_patients/alerts.csv

patient_id | day | split | score | fluid | heart_lungs | daily_life | light | reason | likely_cause | hybrid_red
P0001 | 0 | dev | 0.0 | 0.0 | 0.0 | 0.0 | green |  |  | 0
P0001 | 1 | dev | 0.0 | 0.0 | 0.0 | 0.0 | green |  |  | 0
P0001 | 2 | dev | 0.0 | 0.0 | 0.0 | 0.0 | green |  |  | 0
P0001 | 3 | dev | 0.0 | 0.0 | 0.0 | 0.0 | green |  |  | 0
P0001 | 4 | dev | 0.0 | 0.0 | 0.0 | 0.0 | green |  |  | 0
P0001 | 5 | dev | 0.0 | 0.0 | 0.0 | 0.0 | green |  |  | 0
P0001 | 6 | dev | 0.0 | 0.0 | 0.0 | 0.0 | green |  |  | 0
P0001 | 7 | dev | 0.0 | 0.0 | 0.0 | 0.0 | green |  |  | 0
P0001 | 8 | dev | 0.0 | 0.0 | 0.0 | 0.0 | green |  |  | 0
P0001 | 9 | dev | 0.0 | 0.0 | 0.0 | 0.0 | green |  |  | 0
P0001 | 10 | dev | 0.0 | 0.0 | 0.0 | 0.0 | green |  |  | 0
P0001 | 11 | dev | 0.0 | 0.0 | 0.0 | 0.0 | green |  |  | 0
P0001 | 12 | dev | 0.0 | 0.0 | 0.0 | 0.0 | green |  |  | 0
P0001 | 13 | dev | 1.33 | 0.11 | 1.09 | 0.12 | green |  |  | 0
P0001 | 14 | dev | 1.68 | 0.14 | 0.99 | 0.54 | green |  |  | 0
P0001 | 15 | dev | 2.45 | 0.89 | 0.78 | 0.77 | green |  |  | 0
P0001 | 16 | dev | 3.1 | 0.59 | 1.94 | 0.57 | green |  |  | 0
P0001 | 17 | dev | 2.43 | 0.89 | 1.3 | 0.24 | green |  |  | 0
P0001 | 18 | dev | 3.69 | 1.65 | 1.39 | 0.64 | green |  |  | 0
P0001 | 19 | dev | 3.89 | 1.5 | 1.06 | 1.33 | green |  |  | 0
P0001 | 20 | dev | 3.98 | 2.05 | 1.14 | 0.79 | green |  |  | 0
P0001 | 21 | dev | 3.21 | 1.31 | 0.34 | 1.55 | green |  |  | 0
P0001 | 22 | dev | 2.41 | 0.97 | 0.26 | 1.17 | green |  |  | 0
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
P0004 | 43 | dev | 1.73 | 1.72 | 0.01 | 0.0 | green |  |  | 0
P0004 | 44 | dev | 2.32 | 2.14 | 0.18 | 0.0 | green |  |  | 0
P0004 | 45 | dev | 2.52 | 2.31 | 0.22 | 0.0 | green |  |  | 0
P0004 | 46 | dev | 2.89 | 2.57 | 0.32 | 0.0 | green |  |  | 0
P0004 | 47 | dev | 3.19 | 2.58 | 0.4 | 0.21 | green |  |  | 0
P0004 | 48 | dev | 3.36 | 2.68 | 0.31 | 0.37 | green |  |  | 0
P0004 | 49 | dev | 4.93 | 3.71 | 0.37 | 0.86 | amber | weight +1.3 kg vs normal; leg water outside cells +0.6 % vs normal | after missed medicine | 0
P0004 | 50 | dev | 6.78 | 5.99 | 0.0 | 0.78 | amber | weight +2.0 kg vs normal; leg water outside cells +0.8 % vs normal | after missed medicine | 0
P0004 | 51 | dev | 8.73 | 7.28 | 0.22 | 1.23 | amber | weight +2.4 kg vs normal; leg water outside cells +1.7 % vs normal; stand-up time +5 % vs normal | heart-failure-like (fluid building) | 0
P0004 | 52 | dev | 10.53 | 7.5 | 0.63 | 2.41 | red | weight +2.9 kg vs normal; leg water outside cells +2.1 % vs normal; stand-up time +10 % vs normal | heart-failure-like (fluid building) | 1
P0005 | 0 | dev | 0.0 | 0.0 | 0.0 | 0.0 | green |  |  | 0
P0005 | 1 | dev | 0.0 | 0.0 | 0.0 | 0.0 | green |  |  | 0
P0005 | 2 | dev | 0.0 | 0.0 | 0.0 | 0.0 | green |  |  | 0
P0005 | 3 | dev | 0.0 | 0.0 | 0.0 | 0.0 | green |  |  | 0
P0005 | 4 | dev | 0.0 | 0.0 | 0.0 | 0.0 | green |  |  | 0
P0005 | 5 | dev | 0.0 | 0.0 | 0.0 | 0.0 | green |  |  | 0
P0005 | 6 | dev | 0.0 | 0.0 | 0.0 | 0.0 | green |  |  | 0
P0005 | 7 | dev | 0.0 | 0.0 | 0.0 | 0.0 | green |  |  | 0
P0005 | 8 | dev | 0.0 | 0.0 | 0.0 | 0.0 | green |  |  | 0
P0005 | 9 | dev | 0.0 | 0.0 | 0.0 | 0.0 | green |  |  | 0
P0005 | 10 | dev | 0.0 | 0.0 | 0.0 | 0.0 | green |  |  | 0
P0005 | 11 | dev | 0.0 | 0.0 | 0.0 | 0.0 | green |  |  | 0
P0005 | 12 | dev | 0.0 | 0.0 | 0.0 | 0.0 | green |  |  | 0
P0005 | 13 | dev | 2.65 | 1.43 | 0.34 | 0.88 | green |  |  | 0
P0005 | 14 | dev | 5.85 | 1.98 | 2.66 | 1.21 | amber | resting pulse +5 bpm vs normal; weight +0.5 kg vs normal; activity -8 % vs normal | after missed medicine | 0
P0005 | 15 | dev | 6.65 | 2.62 | 2.44 | 1.59 | amber | weight +0.7 kg vs normal; resting pulse +4 bpm vs normal; activity -11 % vs normal | after missed medicine | 0
P0005 | 16 | dev | 5.44 | 3.07 | 1.92 | 0.45 | amber | weight +0.9 kg vs normal; resting pulse +3 bpm vs normal | after missed medicine | 0
P0005 | 17 | dev | 6.79 | 3.96 | 2.53 | 0.3 | amber | weight +1.1 kg vs normal; resting pulse +3 bpm vs normal; night breathing +1.5 per min vs normal | after missed medicine | 0
P0005 | 18 | dev | 6.21 | 3.04 | 2.45 | 0.72 | amber | weight +1.0 kg vs normal; resting pulse +4 bpm vs normal; night breathing +1.0 per min vs normal | after missed medicine | 0
P0005 | 19 | dev | 6.03 | 3.16 | 1.77 | 1.1 | amber | weight +1.0 kg vs normal; leg reading -2 % vs normal; night breathing +1.2 per min vs normal | after missed medicine | 0
P0005 | 20 | dev | 5.92 | 5.03 | 0.89 | 0.0 | amber | leg reading -5 % vs normal; weight +0.6 kg vs normal | after missed medicine | 0
P0005 | 21 | dev | 6.09 | 4.84 | 1.25 | 0.0 | amber | leg reading -4 % vs normal; night breathing +1.0 per min vs normal; weight +0.5 kg vs normal | heart-failure-like (fluid building) | 0
P0005 | 22 | dev | 4.76 | 4.39 | 0.37 | 0.0 | amber | leg reading -4 % vs normal; weight +0.4 kg vs normal | heart-failure-like (fluid building) | 0
P0005 | 23 | dev | 3.75 | 3.25 | 0.5 | 0.0 | green |  |  | 0
P0005 | 24 | dev | 2.69 | 2.42 | 0.04 | 0.22 | green |  |  | 0
P0005 | 25 | dev | 1.84 | 1.62 | 0.23 | 0.0 | green |  |  | 0
P0005 | 26 | dev | 1.61 | 1.61 | 0.0 | 0.0 | green |  |  | 0
P0005 | 27 | dev | 1.59 | 1.43 | 0.16 | 0.0 | green |  |  | 0
P0005 | 28 | dev | 1.18 | 0.22 | 0.96 | 0.0 | green |  |  | 0
P0005 | 29 | dev | 0.7 | 0.01 | 0.69 | 0.0 | green |  |  | 0
P0005 | 30 | dev | 0.77 | 0.21 | 0.56 | 0.0 | green |  |  | 0
P0005 | 31 | dev | 1.93 | 0.28 | 0.45 | 1.2 | green |  |  | 0
P0005 | 32 | dev | 1.94 | 0.62 | 0.09 | 1.22 | green |  |  | 0
P0005 | 33 | dev | 1.8 | 0.4 | 0.21 | 1.2 | green |  |  | 0
P0005 | 34 | dev | 2.57 | 0.31 | 1.76 | 0.5 | green |  |  | 0
P0005 | 35 | dev | 2.69 | 0.31 | 1.88 | 0.5 | green |  |  | 0
P0005 | 36 | dev | 2.39 | 0.08 | 2.14 | 0.17 | green |  |  | 0
P0005 | 37 | dev | 2.16 | 0.0 | 2.16 | 0.0 | green |  |  | 0
P0005 | 38 | dev | 2.38 | 0.0 | 2.02 | 0.36 | green |  |  | 0
P0005 | 39 | dev | 4.14 | 0.3 | 2.62 | 1.22 | green |  |  | 0
P0005 | 40 | dev | 3.94 | 0.0 | 2.73 | 1.21 | green |  |  | 0
P0005 | 41 | dev | 4.37 | 0.47 | 2.34 | 1.56 | amber | resting pulse +4 bpm vs normal; activity -11 % vs normal | after missed medicine | 0
P0005 | 42 | dev | 4.09 | 1.31 | 1.89 | 0.89 | green |  |  | 0
P0005 | 43 | dev | 5.63 | 2.46 | 2.36 | 0.81 | amber | resting pulse +6 bpm vs normal; leg water outside cells +0.7 % vs normal | after missed medicine | 0
P0005 | 44 | dev | 6.29 | 2.26 | 2.81 | 1.22 | amber | resting pulse +7 bpm vs normal; leg water outside cells +0.6 % vs normal; stand-up time +5 % vs normal | after missed medicine | 0
P0005 | 45 | dev | 7.46 | 2.47 | 3.02 | 1.97 | amber | resting pulse +8 bpm vs normal; leg water outside cells +0.7 % vs normal; stand-up time +8 % vs normal | after missed medicine | 0
P0005 | 46 | dev | 8.3 | 2.11 | 2.79 | 3.4 | red | stand-up time +12 % vs normal; resting pulse +8 bpm vs normal; leg water outside cells +0.7 % vs normal | after missed medicine | 1
P0005 | 47 | dev | 9.26 | 4.71 | 2.57 | 1.97 | red | weight +1.4 kg vs normal; resting pulse +7 bpm vs normal; leg water outside cells +0.8 % vs normal | after missed medicine | 1
P0005 | 48 | dev | 9.96 | 6.15 | 2.32 | 1.49 | red | weight +1.7 kg vs normal; leg water outside cells +1.0 % vs normal; resting pulse +6 bpm vs normal | heart-failure-like (fluid building) | 1
P0005 | 49 | dev | 12.74 | 6.08 | 2.88 | 3.77 | red | weight +1.6 kg vs normal; sitting up at night; leg water outside cells +1.2 % vs normal | heart-failure-like (fluid building) | 1
P0005 | 50 | dev | 15.38 | 6.57 | 2.99 | 5.82 | red | weight +1.8 kg vs normal; sitting up at night; leg water outside cells +1.7 % vs normal | heart-failure-like (fluid building) | 1
P0005 | 51 | dev | 15.98 | 6.65 | 3.13 | 6.21 | red | weight +2.0 kg vs normal; sitting up at night; leg water outside cells +1.9 % vs normal | heart-failure-like (fluid building) | 1
P0005 | 52 | dev | 20.42 | 6.97 | 2.74 | 10.7 | red | sitting up at night; weight +2.8 kg vs normal; leg water outside cells +2.2 % vs normal | heart-failure-like (fluid building) | 1
P0005 | 53 | dev | 20.53 | 7.14 | 3.08 | 10.31 | red | sitting up at night; weight +3.7 kg vs normal; stand-up time +21 % vs normal | heart-failure-like (fluid building) | 1
P0006 | 0 | dev | 0.0 | 0.0 | 0.0 | 0.0 | green |  |  | 0
P0006 | 1 | dev | 0.0 | 0.0 | 0.0 | 0.0 | green |  |  | 0
P0006 | 2 | dev | 0.0 | 0.0 | 0.0 | 0.0 | green |  |  | 0
P0006 | 3 | dev | 0.0 | 0.0 | 0.0 | 0.0 | green |  |  | 0
P0006 | 4 | dev | 0.0 | 0.0 | 0.0 | 0.0 | green |  |  | 0
P0006 | 5 | dev | 0.0 | 0.0 | 0.0 | 0.0 | green |  |  | 0
P0006 | 6 | dev | 0.0 | 0.0 | 0.0 | 0.0 | green |  |  | 0
P0006 | 7 | dev | 0.0 | 0.0 | 0.0 | 0.0 | green |  |  | 0
P0006 | 8 | dev | 1.0 | 0.0 | 0.0 | 1.0 | green |  |  | 0
P0006 | 9 | dev | 1.0 | 0.0 | 0.0 | 1.0 | green |  |  | 0
P0006 | 10 | dev | 2.0 | 0.0 | 0.0 | 2.0 | green |  |  | 0
P0006 | 11 | dev | 0.0 | 0.0 | 0.0 | 0.0 | green |  |  | 0
P0006 | 12 | dev | 0.0 | 0.0 | 0.0 | 0.0 | green |  |  | 0
P0006 | 13 | dev | 1.14 | 0.0 | 0.0 | 1.14 | green |  |  | 0
P0006 | 14 | dev | 1.34 | 0.0 | 0.26 | 1.08 | green |  |  | 0
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
P0010 | 25 | dev | 4.25 | 3.48 | 0.24 | 0.53 | amber | leg water outside cells +0.8 % vs normal; weight +0.4 kg vs normal | heart-failure-like (fluid building) | 0
P0010 | 26 | dev | 5.03 | 4.28 | 0.3 | 0.45 | amber | leg water outside cells +0.9 % vs normal; weight +0.8 kg vs normal | heart-failure-like (fluid building) | 0
P0010 | 27 | dev | 5.5 | 4.82 | 0.22 | 0.47 | amber | leg water outside cells +1.0 % vs normal; weight +1.0 kg vs normal | heart-failure-like (fluid building) | 0
P0010 | 28 | dev | 5.01 | 4.08 | 0.28 | 0.64 | amber | leg water outside cells +0.8 % vs normal; weight +0.9 kg vs normal | after missed medicine | 1
P0010 | 29 | dev | 4.27 | 3.38 | 0.21 | 0.68 | amber | leg water outside cells +0.8 % vs normal; weight +0.7 kg vs normal | after missed medicine | 1
P0010 | 30 | dev | 4.97 | 2.86 | 0.9 | 1.22 | amber | leg water outside cells +0.7 % vs normal; stand-up time +6 % vs normal | after missed medicine | 0
P0010 | 31 | dev | 5.15 | 4.09 | 0.76 | 0.3 | amber | leg water outside cells +1.0 % vs normal; weight +0.8 kg vs normal | after missed medicine | 0
P0010 | 32 | dev | 9.42 | 1.89 | 5.58 | 1.94 | amber | resting pulse +14 bpm vs normal; leg water outside cells +0.6 % vs normal; stand-up time +7 % vs normal | after missed medicine | 0
P0010 | 33 | dev | 10.19 | 2.04 | 5.56 | 2.58 | red | resting pulse +14 bpm vs normal; activity -17 % vs normal; leg water outside cells +0.6 % vs normal | heart-failure-like (fluid building) | 0
P0010 | 34 | dev | 11.45 | 1.59 | 6.1 | 3.76 | red | resting pulse +14 bpm vs normal; activity -29 % vs normal; night breathing +2.4 per min vs normal | heart-failure-like (fluid building) | 0
P0010 | 35 | dev | 9.02 | 2.13 | 4.37 | 2.53 | red | resting pulse +6 bpm vs normal; night breathing +2.6 per min vs normal; activity -20 % vs normal | heart-failure-like (fluid building) | 0
P0010 | 36 | dev | 4.96 | 1.74 | 2.09 | 1.13 | red | night breathing +2.3 per min vs normal; leg reading -2 % vs normal; activity -9 % vs normal | heart-failure-like (fluid building) | 0
P0010 | 37 | dev | 2.37 | 1.4 | 0.98 | 0.0 | green |  |  | 0
P0010 | 38 | dev | 2.88 | 1.31 | 1.24 | 0.34 | green |  |  | 0
P0010 | 39 | dev | 2.67 | 1.49 | 1.13 | 0.06 | green |  |  | 0
P0010 | 40 | dev | 2.01 | 1.56 | 0.44 | 0.0 | green |  |  | 0
P0010 | 41 | dev | 1.43 | 1.2 | 0.24 | 0.0 | green |  |  | 0
P0010 | 42 | dev | 1.25 | 0.75 | 0.29 | 0.21 | green |  |  | 0
P0010 | 43 | dev | 1.17 | 1.15 | 0.0 | 0.02 | green |  |  | 0
P0010 | 44 | dev | 2.74 | 1.79 | 0.0 | 0.96 | green |  |  | 0
P0010 | 45 | dev | 5.69 | 3.81 | 0.62 | 1.26 | amber | leg reading -6 % vs normal; leg water outside cells +1.1 % vs normal; weight +0.4 kg vs normal | heart-failure-like (fluid building) | 0
P0010 | 46 | dev | 9.29 | 5.92 | 1.31 | 2.06 | amber | leg reading -8 % vs normal; leg water outside cells +2.1 % vs normal; weight +0.8 kg vs normal | heart-failure-like (fluid building) | 1
P0010 | 47 | dev | 13.54 | 7.5 | 1.84 | 4.2 | red | leg reading -11 % vs normal; leg water outside cells +3.0 % vs normal; sitting up at night | heart-failure-like (fluid building) | 1
P0011 | 0 | dev | 0.0 | 0.0 | 0.0 | 0.0 | green |  |  | 0
P0011 | 1 | dev | 1.2 | 0.0 | 0.0 | 1.2 | green |  |  | 0
P0011 | 2 | dev | 1.2 | 0.0 | 0.0 | 1.2 | green |  |  | 0
P0011 | 3 | dev | 1.2 | 0.0 | 0.0 | 1.2 | green |  |  | 0
P0011 | 4 | dev | 0.0 | 0.0 | 0.0 | 0.0 | green |  |  | 0
P0011 | 5 | dev | 0.0 | 0.0 | 0.0 | 0.0 | green |  |  | 0
P0011 | 6 | dev | 0.0 | 0.0 | 0.0 | 0.0 | green |  |  | 0
P0011 | 7 | dev | 0.0 | 0.0 | 0.0 | 0.0 | green |  |  | 0
P0011 | 8 | dev | 0.0 | 0.0 | 0.0 | 0.0 | green |  |  | 0
P0011 | 9 | dev | 0.0 | 0.0 | 0.0 | 0.0 | green |  |  | 0
P0011 | 10 | dev | 0.0 | 0.0 | 0.0 | 0.0 | green |  |  | 0
P0011 | 11 | dev | 0.0 | 0.0 | 0.0 | 0.0 | green |  |  | 0
P0011 | 12 | dev | 1.19 | 0.0 | 0.0 | 1.19 | green |  |  | 0
P0011 | 13 | dev | 1.32 | 0.0 | 0.0 | 1.32 | green |  |  | 0
P0011 | 14 | dev | 0.68 | 0.0 | 0.0 | 0.68 | green |  |  | 0
P0011 | 15 | dev | 1.24 | 0.64 | 0.0 | 0.59 | green |  |  | 0
P0011 | 16 | dev | 3.7 | 2.57 | 0.53 | 0.6 | green |  |  | 0
P0011 | 17 | dev | 3.46 | 1.67 | 1.59 | 0.21 | green |  |  | 0
P0011 | 18 | dev | 4.98 | 3.37 | 1.43 | 0.18 | amber | leg water outside cells +1.1 % vs normal; resting pulse +4 bpm vs normal | after missed medicine | 0
P0011 | 19 | dev | 5.15 | 4.26 | 0.8 | 0.09 | amber | leg water outside cells +1.2 % vs normal; weight +0.6 kg vs normal | after missed medicine | 0
P0011 | 20 | dev | 4.61 | 3.85 | 0.76 | 0.0 | amber | leg water outside cells +1.1 % vs normal; weight +0.6 kg vs normal | after missed medicine | 0
P0011 | 21 | dev | 3.37 | 2.4 | 0.8 | 0.16 | green |  |  | 0
P0011 | 22 | dev | 2.61 | 1.24 | 1.37 | 0.0 | green |  |  | 0
P0011 | 23 | dev | 3.81 | 0.88 | 1.5 | 1.44 | green |  |  | 0
P0011 | 24 | dev | 4.96 | 0.53 | 1.96 | 2.47 | amber | breathless or extra pillows reported; resting pulse +5 bpm vs normal | unclear: please check | 0
P0011 | 25 | dev | 4.94 | 0.75 | 1.79 | 2.4 | amber | breathless or extra pillows reported; resting pulse +5 bpm vs normal | unclear: please check | 0
P0011 | 26 | dev | 4.33 | 0.65 | 2.48 | 1.2 | amber | resting pulse +5 bpm vs normal; breathless or extra pillows reported | infection-like (pulse and breathing up, fluid steady) | 0
P0011 | 27 | dev | 2.34 | 0.02 | 2.14 | 0.17 | green |  |  | 0
P0011 | 28 | dev | 2.41 | 0.0 | 2.41 | 0.0 | green |  |  | 0
P0011 | 29 | dev | 2.86 | 0.0 | 2.86 | 0.0 | green |  |  | 0
P0011 | 30 | dev | 2.84 | 0.03 | 2.58 | 0.23 | green |  |  | 0
P0011 | 31 | dev | 2.49 | 0.23 | 2.26 | 0.0 | green |  |  | 0
P0011 | 32 | dev | 1.48 | 0.32 | 0.81 | 0.35 | green |  |  | 0
P0011 | 33 | dev | 0.1 | 0.0 | 0.1 | 0.0 | green |  |  | 0
P0011 | 34 | dev | 0.3 | 0.0 | 0.12 | 0.17 | green |  |  | 0
P0011 | 35 | dev | 0.58 | 0.0 | 0.58 | 0.0 | green |  |  | 0
P0011 | 36 | dev | 1.8 | 0.0 | 0.68 | 1.12 | green |  |  | 0
P0011 | 37 | dev | 1.86 | 0.0 | 0.9 | 0.97 | green |  |  | 0
P0011 | 38 | dev | 2.51 | 0.59 | 0.81 | 1.11 | green |  |  | 0
P0011 | 39 | dev | 2.7 | 1.67 | 0.72 | 0.31 | green |  |  | 0
P0011 | 40 | dev | 3.22 | 1.93 | 0.72 | 0.58 | green |  |  | 0
P0011 | 41 | dev | 2.98 | 2.43 | 0.02 | 0.53 | green |  |  | 0
P0011 | 42 | dev | 3.63 | 2.66 | 0.14 | 0.83 | green |  |  | 0
P0011 | 43 | dev | 5.36 | 4.23 | 0.28 | 0.84 | amber | weight +1.0 kg vs normal; leg water outside cells +0.7 % vs normal | after missed medicine | 0
P0011 | 44 | dev | 5.96 | 2.8 | 1.76 | 1.4 | amber | weight +0.8 kg vs normal; resting pulse +5 bpm vs normal; sitting up at night | heart-failure-like (fluid building) | 0
P0011 | 45 | dev | 10.46 | 4.81 | 2.34 | 3.31 | amber | weight +1.4 kg vs normal; sitting up at night; resting pulse +6 bpm vs normal | heart-failure-like (fluid building) | 0
P0011 | 46 | dev | 13.49 | 3.77 | 3.27 | 6.45 | red | sitting up at night; weight +1.3 kg vs normal; resting pulse +8 bpm vs normal | heart-failure-like (fluid building) | 1
P0011 | 47 | dev | 14.19 | 6.98 | 1.83 | 5.37 | red | weight +2.8 kg vs normal; sitting up at night; leg water outside cells +1.8 % vs normal | heart-failure-like (fluid building) | 1
P0011 | 48 | dev | 4.3 | 0.0 | 1.7 | 2.6 | red | sitting up at night; night breathing +1.4 per min vs normal; breathless or extra pillows reported | unclear: please check | 1
P0012 | 0 | test | 0.0 | 0.0 | 0.0 | 0.0 | green |  |  | 0
P0012 | 1 | test | 1.0 | 0.0 | 0.0 | 1.0 | green |  |  | 0
P0012 | 2 | test | 1.0 | 0.0 | 0.0 | 1.0 | green |  |  | 0
P0012 | 3 | test | 0.0 | 0.0 | 0.0 | 0.0 | green |  |  | 0
P0012 | 4 | test | 0.0 | 0.0 | 0.0 | 0.0 | green |  |  | 0
P0012 | 5 | test | 0.0 | 0.0 | 0.0 | 0.0 | green |  |  | 0
P0012 | 6 | test | 0.0 | 0.0 | 0.0 | 0.0 | green |  |  | 0
P0012 | 7 | test | 0.0 | 0.0 | 0.0 | 0.0 | green |  |  | 0
P0012 | 8 | test | 0.0 | 0.0 | 0.0 | 0.0 | green |  |  | 0
P0012 | 9 | test | 0.0 | 0.0 | 0.0 | 0.0 | green |  |  | 0
P0012 | 10 | test | 0.0 | 0.0 | 0.0 | 0.0 | green |  |  | 0
P0012 | 11 | test | 0.0 | 0.0 | 0.0 | 0.0 | green |  |  | 0
P0012 | 12 | test | 0.0 | 0.0 | 0.0 | 0.0 | green |  |  | 0
P0012 | 13 | test | 0.0 | 0.0 | 0.0 | 0.0 | green |  |  | 0
P0012 | 14 | test | 1.31 | 0.0 | 0.0 | 1.31 | green |  |  | 0
P0012 | 15 | test | 3.36 | 1.27 | 0.28 | 1.81 | green |  |  | 0
P0012 | 16 | test | 3.3 | 1.19 | 0.65 | 1.46 | green |  |  | 0
P0012 | 17 | test | 3.76 | 1.2 | 0.97 | 1.59 | green |  |  | 0
P0012 | 18 | test | 2.96 | 0.63 | 0.95 | 1.39 | green |  |  | 0
P0012 | 19 | test | 3.38 | 0.48 | 0.8 | 2.1 | green |  |  | 0
P0012 | 20 | test | 4.65 | 1.83 | 1.07 | 1.75 | amber | weight +0.9 kg vs normal; stand-up time +7 % vs normal | after missed medicine | 0
P0012 | 21 | test | 6.03 | 2.46 | 1.54 | 2.03 | amber | weight +1.2 kg vs normal; stand-up time +7 % vs normal; resting pulse +3 bpm vs normal | after missed medicine | 0
P0012 | 22 | test | 5.24 | 2.18 | 1.7 | 1.37 | amber | weight +1.0 kg vs normal; resting pulse +3 bpm vs normal; sitting up at night | after missed medicine | 0
P0012 | 23 | test | 4.86 | 1.55 | 1.97 | 1.35 | amber | resting pulse +3 bpm vs normal; weight +0.7 kg vs normal; sitting up at night | after missed medicine | 0
P0012 | 24 | test | 4.64 | 1.71 | 2.26 | 0.67 | amber | resting pulse +4 bpm vs normal; weight +0.7 kg vs normal | after missed medicine | 0
P0012 | 25 | test | 4.89 | 2.05 | 2.66 | 0.18 | amber | resting pulse +4 bpm vs normal; leg reading -2 % vs normal; night breathing +1.2 per min vs normal | after missed medicine | 0
P0012 | 26 | test | 3.35 | 1.53 | 1.82 | 0.0 | green |  |  | 0
P0012 | 27 | test | 2.33 | 0.93 | 1.4 | 0.0 | green |  |  | 0
P0012 | 28 | test | 1.4 | 0.44 | 0.91 | 0.05 | green |  |  | 0
P0012 | 29 | test | 1.82 | 0.33 | 1.19 | 0.29 | green |  |  | 0
P0012 | 30 | test | 1.61 | 0.49 | 1.12 | 0.0 | green |  |  | 0
P0012 | 31 | test | 1.68 | 0.65 | 1.03 | 0.0 | green |  |  | 0
P0012 | 32 | test | 1.56 | 0.76 | 0.8 | 0.0 | green |  |  | 0
P0012 | 33 | test | 3.16 | 0.85 | 1.05 | 1.26 | green |  |  | 0
P0012 | 34 | test | 3.29 | 1.66 | 0.28 | 1.35 | green |  |  | 0
P0012 | 35 | test | 3.02 | 1.2 | 0.45 | 1.38 | green |  |  | 0
P0012 | 36 | test | 1.0 | 0.31 | 0.55 | 0.15 | green |  |  | 0
P0012 | 37 | test | 1.08 | 0.11 | 0.98 | 0.0 | green |  |  | 0
P0012 | 38 | test | 0.77 | 0.18 | 0.6 | 0.0 | green |  |  | 0
P0012 | 39 | test | 1.01 | 0.0 | 1.01 | 0.0 | green |  |  | 0
P0012 | 40 | test | 1.0 | 0.0 | 0.9 | 0.1 | green |  |  | 0
P0012 | 41 | test | 2.63 | 0.0 | 1.29 | 1.34 | green |  |  | 0
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
P0014 | 35 | dev | 7.2 | 2.69 | 2.97 | 1.55 | amber | night breathing +2.4 per min vs normal; weight +1.1 kg vs normal; resting pulse +7 bpm vs normal | heart-failure-like (fluid building) | 0
P0014 | 36 | dev | 9.42 | 2.2 | 4.67 | 2.55 | red | night breathing +3.2 per min vs normal; activity -20 % vs normal; resting pulse +11 bpm vs normal | heart-failure-like (fluid building) | 0
P0014 | 37 | dev | 10.44 | 2.34 | 4.81 | 3.29 | red | resting pulse +9 bpm vs normal; activity -26 % vs normal; night breathing +3.1 per min vs normal | heart-failure-like (fluid building) | 1
P0014 | 38 | dev | 10.56 | 2.58 | 4.32 | 3.66 | red | activity -29 % vs normal; resting pulse +9 bpm vs normal; night breathing +2.9 per min vs normal | heart-failure-like (fluid building) | 1
P0014 | 39 | dev | 11.51 | 2.49 | 5.18 | 3.84 | red | activity -29 % vs normal; night breathing +3.8 per min vs normal; resting pulse +9 bpm vs normal | heart-failure-like (fluid building) | 1
P0014 | 40 | dev | 11.41 | 2.35 | 5.54 | 3.52 | red | night breathing +4.3 per min vs normal; activity -27 % vs normal; resting pulse +8 bpm vs normal | heart-failure-like (fluid building) | 1
P0014 | 41 | dev | 5.06 | 1.14 | 2.63 | 1.29 | red | night breathing +2.7 per min vs normal; activity -10 % vs normal; leg reading -2 % vs normal | unclear: please check | 1
P0014 | 42 | dev | 1.21 | 0.84 | 0.37 | 0.0 | green |  |  | 0
P0014 | 43 | dev | 2.47 | 2.24 | 0.23 | 0.0 | green |  |  | 0
P0014 | 44 | dev | 3.09 | 2.96 | 0.08 | 0.06 | green |  |  | 0
P0014 | 45 | dev | 2.26 | 2.26 | 0.0 | 0.0 | green |  |  | 0
P0014 | 46 | dev | 2.29 | 2.29 | 0.0 | 0.0 | green |  |  | 0
P0014 | 47 | dev | 2.6 | 2.47 | 0.0 | 0.12 | green |  |  | 0
P0014 | 48 | dev | 3.18 | 2.02 | 0.42 | 0.74 | green |  |  | 0
P0014 | 49 | dev | 3.83 | 2.22 | 0.83 | 0.78 | green |  |  | 0
P0014 | 50 | dev | 4.26 | 3.02 | 0.93 | 0.31 | amber | leg water outside cells +1.0 % vs normal; leg reading -2 % vs normal | heart-failure-like (fluid building) | 0
P0014 | 51 | dev | 7.96 | 4.47 | 0.2 | 3.29 | amber | leg water outside cells +1.8 % vs normal; sitting up at night; leg reading -3 % vs normal | heart-failure-like (fluid building) | 1
P0014 | 52 | dev | 11.28 | 6.68 | 0.0 | 4.6 | red | leg water outside cells +2.7 % vs normal; sitting up at night; leg reading -5 % vs normal | heart-failure-like (fluid building) | 1
P0014 | 53 | dev | 12.62 | 7.5 | 0.43 | 4.68 | red | leg reading -7 % vs normal; leg water outside cells +3.3 % vs normal; sitting up at night | heart-failure-like (fluid building) | 1
P0014 | 54 | dev | 14.56 | 7.5 | 1.16 | 5.9 | red | leg reading -8 % vs normal; leg water outside cells +3.6 % vs normal; sitting up at night | heart-failure-like (fluid building) | 1
P0015 | 0 | test | 0.0 | 0.0 | 0.0 | 0.0 | green |  |  | 0
P0015 | 1 | test | 0.0 | 0.0 | 0.0 | 0.0 | green |  |  | 0
P0015 | 2 | test | 0.0 | 0.0 | 0.0 | 0.0 | green |  |  | 0
P0015 | 3 | test | 0.0 | 0.0 | 0.0 | 0.0 | green |  |  | 0
P0015 | 4 | test | 0.0 | 0.0 | 0.0 | 0.0 | green |  |  | 0
P0015 | 5 | test | 0.0 | 0.0 | 0.0 | 0.0 | green |  |  | 0
P0015 | 6 | test | 0.0 | 0.0 | 0.0 | 0.0 | green |  |  | 0
P0015 | 7 | test | 0.0 | 0.0 | 0.0 | 0.0 | green |  |  | 0
P0015 | 8 | test | 0.0 | 0.0 | 0.0 | 0.0 | green |  |  | 0
P0015 | 9 | test | 0.0 | 0.0 | 0.0 | 0.0 | green |  |  | 0
P0015 | 10 | test | 0.0 | 0.0 | 0.0 | 0.0 | green |  |  | 0
P0015 | 11 | test | 0.0 | 0.0 | 0.0 | 0.0 | green |  |  | 0
P0015 | 12 | test | 4.14 | 1.7 | 1.74 | 0.7 | green |  |  | 0
P0015 | 13 | test | 3.9 | 1.59 | 1.9 | 0.41 | green |  |  | 0
P0015 | 14 | test | 3.52 | 1.6 | 1.6 | 0.32 | green |  |  | 0
P0015 | 15 | test | 3.26 | 1.55 | 1.72 | 0.0 | green |  |  | 0
P0015 | 16 | test | 4.05 | 1.37 | 2.11 | 0.57 | green |  |  | 0
P0015 | 17 | test | 4.24 | 1.61 | 1.76 | 0.87 | amber | resting pulse +4 bpm vs normal; leg water outside cells +0.3 % vs normal | after missed medicine | 0
P0015 | 18 | test | 4.87 | 2.19 | 1.26 | 1.43 | amber | leg water outside cells +0.5 % vs normal; stand-up time +7 % vs normal; resting pulse +3 bpm vs normal | after missed medicine | 0
P0015 | 19 | test | 4.42 | 2.29 | 0.99 | 1.14 | amber | leg water outside cells +0.5 % vs normal; leg reading -2 % vs normal; stand-up time +4 % vs normal | after missed medicine | 0
P0015 | 20 | test | 5.33 | 3.36 | 0.32 | 1.65 | amber | leg water outside cells +0.7 % vs normal; leg reading -4 % vs normal; stand-up time +7 % vs normal | heart-failure-like (fluid building) | 1
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
P0018 | 15 | dev | 2.39 | 1.47 | 0.91 | 0.02 | green |  |  | 0
P0018 | 16 | dev | 3.98 | 2.11 | 1.45 | 0.42 | green |  |  | 0
P0018 | 17 | dev | 6.05 | 3.69 | 1.45 | 0.91 | amber | leg reading -4 % vs normal; resting pulse +2 bpm vs normal | heart-failure-like (fluid building) | 0
P0018 | 18 | dev | 6.06 | 3.99 | 1.37 | 0.7 | amber | leg reading -4 % vs normal; leg water outside cells +0.7 % vs normal; weight +0.5 kg vs normal | heart-failure-like (fluid building) | 0
P0018 | 19 | dev | 6.65 | 4.53 | 1.19 | 0.93 | amber | leg water outside cells +1.0 % vs normal; leg reading -4 % vs normal; weight +0.7 kg vs normal | heart-failure-like (fluid building) | 0
P0018 | 20 | dev | 6.95 | 4.1 | 1.1 | 1.75 | amber | leg water outside cells +0.9 % vs normal; leg reading -4 % vs normal; activity -12 % vs normal | heart-failure-like (fluid building) | 1
P0018 | 21 | dev | 5.65 | 3.14 | 0.37 | 2.15 | amber | leg reading -4 % vs normal; stand-up time +11 % vs normal; leg water outside cells +0.6 % vs normal | heart-failure-like (fluid building) | 1
P0018 | 22 | dev | 4.06 | 2.38 | 0.67 | 1.01 | green |  |  | 1
P0018 | 23 | dev | 2.24 | 1.62 | 0.38 | 0.23 | green |  |  | 1
P0018 | 24 | dev | 2.03 | 1.76 | 0.27 | 0.0 | green |  |  | 0
P0018 | 25 | dev | 2.07 | 2.03 | 0.04 | 0.0 | green |  |  | 0
P0018 | 26 | dev | 2.49 | 1.85 | 0.0 | 0.64 | green |  |  | 0
P0018 | 27 | dev | 3.35 | 2.41 | 0.12 | 0.83 | green |  |  | 0
P0018 | 28 | dev | 2.69 | 2.18 | 0.3 | 0.2 | green |  |  | 0
P0018 | 29 | dev | 2.44 | 1.57 | 0.57 | 0.29 | green |  |  | 0
P0018 | 30 | dev | 1.58 | 0.8 | 0.38 | 0.4 | green |  |  | 0
P0018 | 31 | dev | 1.25 | 0.84 | 0.14 | 0.27 | green |  |  | 0
P0018 | 32 | dev | 1.14 | 1.1 | 0.03 | 0.0 | green |  |  | 0
P0018 | 33 | dev | 0.88 | 0.88 | 0.0 | 0.0 | green |  |  | 0
P0018 | 34 | dev | 0.21 | 0.08 | 0.0 | 0.13 | green |  |  | 0
P0018 | 35 | dev | 0.42 | 0.29 | 0.0 | 0.13 | green |  |  | 0
P0018 | 36 | dev | 1.39 | 0.54 | 0.19 | 0.66 | green |  |  | 0
P0018 | 37 | dev | 1.04 | 0.83 | 0.2 | 0.0 | green |  |  | 0
P0018 | 38 | dev | 0.8 | 0.78 | 0.02 | 0.0 | green |  |  | 0
P0018 | 39 | dev | 1.35 | 1.17 | 0.0 | 0.17 | green |  |  | 0
P0018 | 40 | dev | 1.45 | 1.45 | 0.0 | 0.0 | green |  |  | 0
P0018 | 41 | dev | 1.7 | 1.54 | 0.16 | 0.0 | green |  |  | 0
P0018 | 42 | dev | 2.06 | 1.16 | 0.7 | 0.19 | green |  |  | 0
P0018 | 43 | dev | 3.21 | 1.31 | 1.29 | 0.62 | green |  |  | 0
P0018 | 44 | dev | 4.93 | 2.22 | 1.74 | 0.96 | amber | weight +0.9 kg vs normal; resting pulse +5 bpm vs normal | after missed medicine | 0
P0018 | 45 | dev | 6.74 | 3.46 | 2.92 | 0.36 | amber | weight +1.4 kg vs normal; resting pulse +6 bpm vs normal; night breathing +1.1 per min vs normal | after missed medicine | 0
P0018 | 46 | dev | 10.45 | 4.95 | 3.47 | 2.03 | amber | weight +2.0 kg vs normal; resting pulse +7 bpm vs normal; leg water outside cells +0.6 % vs normal | after missed medicine | 0
P0018 | 47 | dev | 12.47 | 5.8 | 4.27 | 2.4 | red | weight +2.3 kg vs normal; resting pulse +9 bpm vs normal; activity -14 % vs normal | after missed medicine | 1
P0018 | 48 | dev | 13.83 | 5.78 | 3.88 | 4.17 | red | weight +2.9 kg vs normal; sitting up at night; resting pulse +9 bpm vs normal | after missed medicine | 1
P0018 | 49 | dev | 15.17 | 5.63 | 4.45 | 5.09 | red | weight +3.0 kg vs normal; sitting up at night; resting pulse +10 bpm vs normal | after missed medicine | 1
P0018 | 50 | dev | 19.58 | 6.32 | 3.87 | 9.39 | red | sitting up at night; weight +3.7 kg vs normal; stand-up time +16 % vs normal | heart-failure-like (fluid building) | 1
P0019 | 0 | dev | 0.0 | 0.0 | 0.0 | 0.0 | green |  |  | 0
P0019 | 1 | dev | 1.2 | 0.0 | 0.0 | 1.2 | green |  |  | 0
P0019 | 2 | dev | 1.2 | 0.0 | 0.0 | 1.2 | green |  |  | 0
P0019 | 3 | dev | 0.0 | 0.0 | 0.0 | 0.0 | green |  |  | 0
P0019 | 4 | dev | 0.0 | 0.0 | 0.0 | 0.0 | green |  |  | 0
P0019 | 5 | dev | 0.0 | 0.0 | 0.0 | 0.0 | green |  |  | 0
P0019 | 6 | dev | 0.0 | 0.0 | 0.0 | 0.0 | green |  |  | 0
P0019 | 7 | dev | 0.0 | 0.0 | 0.0 | 0.0 | green |  |  | 0
P0019 | 8 | dev | 0.0 | 0.0 | 0.0 | 0.0 | green |  |  | 0
P0019 | 9 | dev | 0.0 | 0.0 | 0.0 | 0.0 | green |  |  | 0
P0019 | 10 | dev | 0.0 | 0.0 | 0.0 | 0.0 | green |  |  | 0
P0019 | 11 | dev | 0.0 | 0.0 | 0.0 | 0.0 | green |  |  | 0
P0019 | 12 | dev | 3.95 | 1.97 | 1.68 | 0.31 | green |  |  | 0
P0019 | 13 | dev | 3.1 | 1.6 | 0.85 | 0.65 | green |  |  | 0
P0019 | 14 | dev | 2.63 | 1.31 | 0.15 | 1.17 | green |  |  | 0
P0019 | 15 | dev | 2.86 | 1.36 | 0.16 | 1.34 | green |  |  | 0
P0019 | 16 | dev | 1.56 | 0.88 | 0.0 | 0.68 | green |  |  | 0
P0019 | 17 | dev | 1.56 | 1.2 | 0.3 | 0.06 | green |  |  | 0
P0019 | 18 | dev | 2.23 | 1.72 | 0.38 | 0.13 | green |  |  | 0
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
P0027 | 42 | dev | 12.54 | 6.91 | 3.28 | 2.34 | red | leg water outside cells +1.7 % vs normal; weight +1.2 kg vs normal; resting pulse +6 bpm vs normal | heart-failure-like (fluid building) | 1
P0027 | 43 | dev | 13.52 | 7.27 | 3.4 | 2.85 | red | leg water outside cells +1.9 % vs normal; weight +1.5 kg vs normal; leg reading -5 % vs normal | heart-failure-like (fluid building) | 1
P0027 | 44 | dev | 14.25 | 7.5 | 4.0 | 2.74 | red | weight +1.6 kg vs normal; leg water outside cells +2.2 % vs normal; leg reading -6 % vs normal | heart-failure-like (fluid building) | 1
P0027 | 45 | dev | 16.24 | 7.5 | 3.73 | 5.0 | red | weight +1.8 kg vs normal; leg water outside cells +2.6 % vs normal; leg reading -6 % vs normal | heart-failure-like (fluid building) | 1
P0028 | 0 | dev | 0.0 | 0.0 | 0.0 | 0.0 | green |  |  | 0
P0028 | 1 | dev | 0.0 | 0.0 | 0.0 | 0.0 | green |  |  | 0
P0028 | 2 | dev | 0.0 | 0.0 | 0.0 | 0.0 | green |  |  | 0
P0028 | 3 | dev | 0.0 | 0.0 | 0.0 | 0.0 | green |  |  | 0
P0028 | 4 | dev | 0.0 | 0.0 | 0.0 | 0.0 | green |  |  | 0
P0028 | 5 | dev | 0.0 | 0.0 | 0.0 | 0.0 | green |  |  | 0
P0028 | 6 | dev | 0.0 | 0.0 | 0.0 | 0.0 | green |  |  | 0
P0028 | 7 | dev | 0.0 | 0.0 | 0.0 | 0.0 | green |  |  | 0
P0028 | 8 | dev | 0.0 | 0.0 | 0.0 | 0.0 | green |  |  | 0
P0028 | 9 | dev | 0.0 | 0.0 | 0.0 | 0.0 | green |  |  | 0
P0028 | 10 | dev | 0.0 | 0.0 | 0.0 | 0.0 | green |  |  | 0
P0028 | 11 | dev | 0.0 | 0.0 | 0.0 | 0.0 | green |  |  | 0
P0028 | 12 | dev | 2.87 | 1.15 | 1.5 | 0.22 | green |  |  | 0
P0028 | 13 | dev | 2.72 | 1.79 | 0.92 | 0.0 | green |  |  | 0
P0028 | 14 | dev | 4.41 | 1.82 | 1.13 | 1.45 | amber | leg water outside cells +0.5 % vs normal; activity -18 % vs normal | heart-failure-like (fluid building) | 0
P0028 | 15 | dev | 3.62 | 2.1 | 0.67 | 0.85 | green |  |  | 0
P0028 | 16 | dev | 4.11 | 2.07 | 1.67 | 0.37 | green |  |  | 0
P0028 | 17 | dev | 4.61 | 2.47 | 1.86 | 0.29 | amber | leg water outside cells +0.7 % vs normal; night breathing +1.1 per min vs normal; resting pulse +3 bpm vs normal | heart-failure-like (fluid building) | 0
P0028 | 18 | dev | 3.6 | 2.41 | 0.98 | 0.2 | green |  |  | 0
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
