aadityaa0523/HridayMitra/source_code/benchmark/submissions/hridaymitra_hybrid_test.csv

patient_id | day | light
P0009 | 0 | 0
P0009 | 1 | 0
P0009 | 2 | 0
P0009 | 3 | 0
P0009 | 4 | 0
P0009 | 5 | 0
P0009 | 6 | 0
P0009 | 7 | 0
P0009 | 8 | 0
P0009 | 9 | 0
P0009 | 10 | 0
P0009 | 11 | 0
P0009 | 12 | 1
P0009 | 13 | 1
P0009 | 14 | 0
P0009 | 15 | 0
P0009 | 16 | 0
P0009 | 17 | 1
P0009 | 18 | 0
P0009 | 19 | 0
P0009 | 20 | 1
P0009 | 21 | 1
P0009 | 22 | 1
P0009 | 23 | 0
P0009 | 24 | 0
P0009 | 25 | 0
P0009 | 26 | 1
P0009 | 27 | 1
P0009 | 28 | 1
P0009 | 29 | 1
P0009 | 30 | 1
P0009 | 31 | 1
P0009 | 32 | 1
P0009 | 33 | 1
P0009 | 34 | 1
P0009 | 35 | 0
P0009 | 36 | 0
P0009 | 37 | 0
P0009 | 38 | 0
P0009 | 39 | 0
P0009 | 40 | 0
P0009 | 41 | 0
P0009 | 42 | 0
P0009 | 43 | 0
P0009 | 44 | 0
P0009 | 45 | 0
P0009 | 46 | 1
P0009 | 47 | 0
P0009 | 48 | 0
P0009 | 49 | 0
P0009 | 50 | 1
P0009 | 51 | 0
P0009 | 52 | 0
P0009 | 53 | 0
P0009 | 54 | 0
P0009 | 55 | 0
P0009 | 56 | 0
P0009 | 57 | 0
P0009 | 58 | 0
P0009 | 59 | 0
P0012 | 0 | 0
P0012 | 1 | 0
P0012 | 2 | 0
P0012 | 3 | 0
P0012 | 4 | 0
P0012 | 5 | 0
P0012 | 6 | 0
P0012 | 7 | 0
P0012 | 8 | 0
P0012 | 9 | 0
P0012 | 10 | 0
P0012 | 11 | 0
P0012 | 12 | 0
P0012 | 13 | 0
P0012 | 14 | 0
P0012 | 15 | 1
P0012 | 16 | 1
P0012 | 17 | 1
P0012 | 18 | 1
P0012 | 19 | 1
P0012 | 20 | 1
P0012 | 21 | 1
P0012 | 22 | 1
P0012 | 23 | 1
P0012 | 24 | 1
P0012 | 25 | 1
P0012 | 26 | 1
P0012 | 27 | 1
P0012 | 28 | 0
P0012 | 29 | 0
P0012 | 30 | 0
P0012 | 31 | 0
P0012 | 32 | 0
P0012 | 33 | 1
P0012 | 34 | 1
P0012 | 35 | 1
P0012 | 36 | 0
P0012 | 37 | 0
P0012 | 38 | 0
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
P0199 | 41 | 1
P0199 | 42 | 0
P0199 | 43 | 0
P0199 | 44 | 1
P0199 | 45 | 1
P0199 | 46 | 0
P0199 | 47 | 0
P0199 | 48 | 0
P0199 | 49 | 0
P0199 | 50 | 0
P0199 | 51 | 1
P0199 | 52 | 1
P0199 | 53 | 1
P0199 | 54 | 1
P0199 | 55 | 1
P0199 | 56 | 1
P0199 | 57 | 1
P0199 | 58 | 1
P0199 | 59 | 1
