aadityaa0523/HridayMitra/source_code/reports/cost_simulation.png

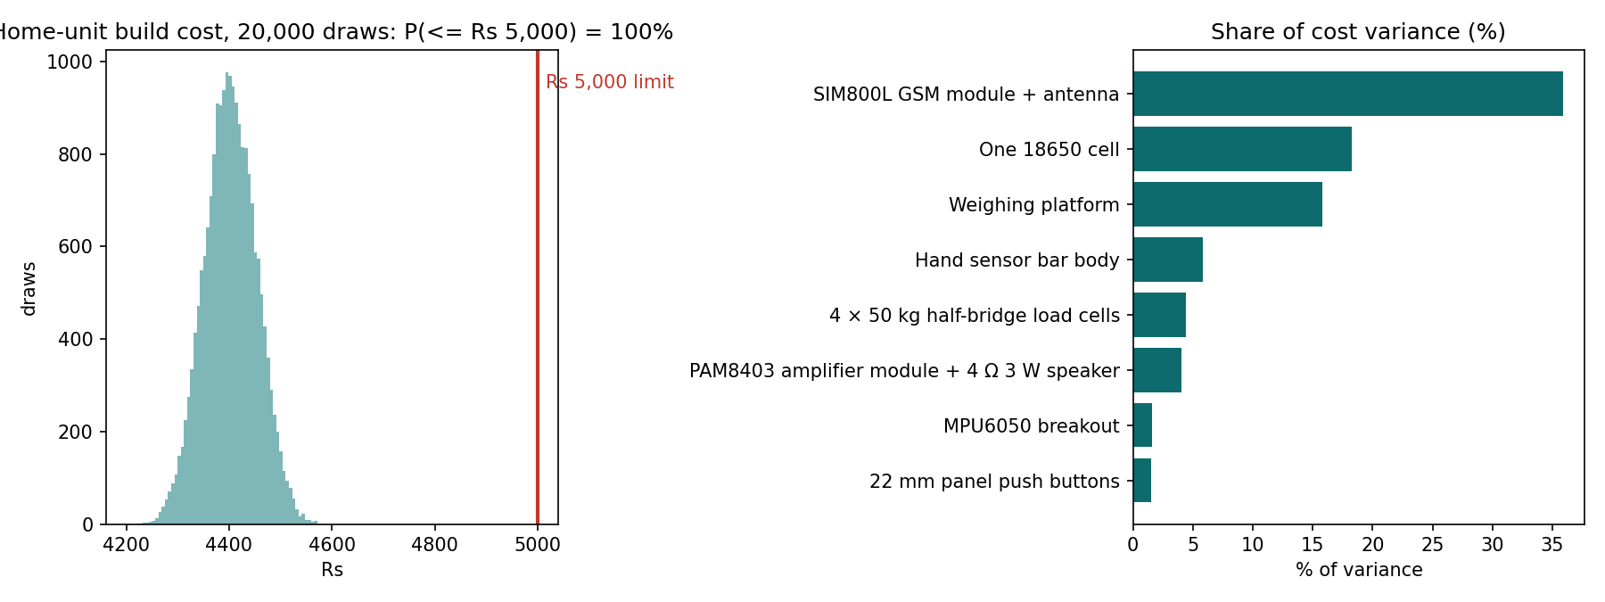
source_code/reports/cost_simulation.png
