aadityaa0523/HridayMitra/source_code/docs/HridayMitra physical build pack.pdf

# HridayMitra: physical build pack

Monitoring only, not a diagnosis tool. Never test on anyone with a pacemaker or defibrillator. Run from battery when a person touches the electrodes.

Read first. These are starting dimensions, not tested. Buy the stool first, then adjust sizes to fit it. Two changes from the v3 guide: (1) the gap between the fore-foot and heel plate is now about 8 cm (the arch of the foot), not 2 cm, because a real foot only touches the ball and the heel; the circuit does not care. (2) The post is a 40 mm wooden post (easier than PVC, and the cables run outside it in clips). The impedance board still needs the phantom test before any foot touches it.

## 1. What you are building

A flat plywood plate that rests on 4 load cells. Everything the patient touches (stool, post, handle, foot plates) is fixed to the plate, so leaning on the handle does not change the weight. The laptop engine reads the numbers over USB.

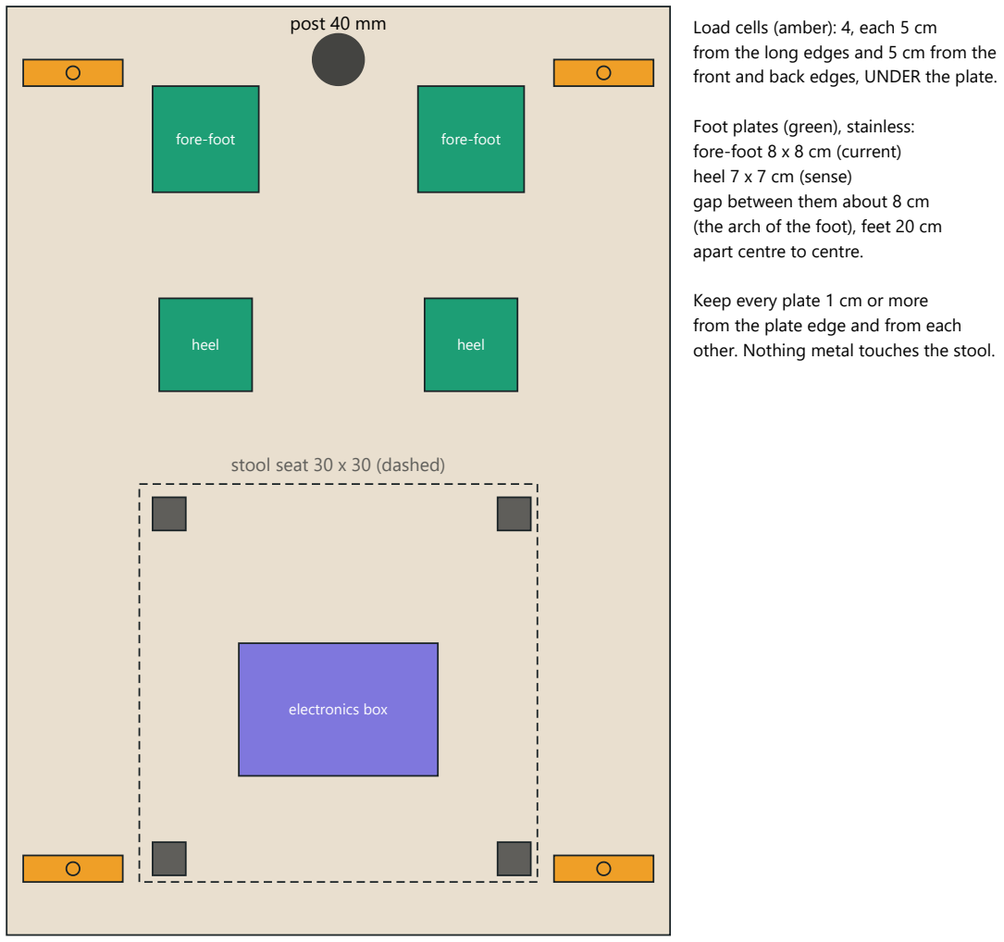
[picture p47: figure]
fore-foot; heel; electronics box; post 40 mm; stool seat 30 x 30 (dashed); Load cells (amber): 4, each 5 cm from the long edges and 5 cm from the front and back edges, UNDER the plate.; Foot plates (green), stainless: fore-foot 8 x 8 cm (current) heel 7 x 7 cm (sense) gap between them about 8 cm (the arch of the foot), feet 20 cm apart centre to centre.; Keep every plate 1 cm or more from the plate edge and from each other. Nothing metal touches the stool.

plywood base plate 50 x 70 cm, 18 mm (front = top of drawing)

## 2. Side view

plywood plate 18 mm

stool seat

box

panel

seat 42 cm

e 68 cm

Side view (not to scale)

Handle bar 25 cm, pointing to the patient, grips with 2 stainless strips per hand (green).
Finger clip on the bar next to
the post (amber).

Panel on top of the post: 3 LEDs,
3 buttons, speaker.

Seat height 42 cm, handle bar 68 cm above the plate: adjust to the
stool you buy: handle bar should be about elbow height when seated.

## 3. Cut list and materials (physical parts only)

Part | Qty | Size | Material and note
Base plate | 1 | 50 x 70 cm, 18 mm | Plywood or MDF. Ask the shop to cut it. Sand the edges.
Load cells | 4 | 50 kg, about 75 mm bar or half-bridge type | Check the type with the seller (see build guide v3). One end bolted to the plate, the other on a rubber foot.
Load-cell spacers and bolts | 8 + 8 | M5 x 25 mm, washers, 5-6 mm spacers | The cell must have a gap of about 1 mm to flex. Follow the mounting picture on the seller's page.
Rubber feet | 4 | Hard rubber, about 3 cm | Under the free end of each cell
Stool | 1 | Flat 30 x 30 cm seat, 42 cm high, rated 100 kg+ | Fix each leg with an L-bracket or two screws through a wooden block glued to the plate. The stool must not lift or slide.
Post | 1 | 40 x 40 mm, 90 cm | Wood. Fix with 2 L-brackets and 4 screws to the plate at the front centre.
Handle bar | 1 | 25 mm round, 28 cm | Wooden dowel or PVC pipe, screwed to the post at 68 cm
Foot plates | 4 | 2 of 8 x 8 cm, 2 of 7 x 7 cm | Stainless steel 304, 0.5-1 mm. Round every corner. M3 screw and nut at the centre; wire on the underside.

Hand strips | 4 | 10 x 2 cm | Stainless. Wrap and screw to the handle bar, 3 cm or more between strips.
Electronics box | 1 | 150 x 100 x 50 mm | Screwed to the plate between the stool legs
Panel box | 1 | about 14 x 9 cm | On top of the post: 3 LEDs, 3 buttons, speaker
Cable clips, zip ties, cable sleeve | 1 set | | Cables run along the post to the box

Tools: drill and 3.2 / 5.5 mm bits, screwdrivers, spanner for M5, tin snips or hacksaw, file and sandpaper, ruler, pencil, soldering iron, multimeter, wire strippers, crimper.

## 4. Assembly steps, in order (about 5-6 hours)

Step | Do | Check before moving on
1. Plate | Cut and sand the plate. Mark the 4 load-cell positions (5 cm from the edges) and drill holes. | Plate lies flat; holes line up with the cells
2. Load cells | Bolt each cell to the underside with spacers, rubber foot on the free end. Wire to the HX711 (per build guide v3, section 4). | Readings change when you press each corner, and return to zero. Do this before adding anything else.
3. Calibrate | Put 1, 2 and 5 L water bottles on the plate (1 L is about 1 kg). Store the scale factor. | 5 kg reads 5 kg within 0.1 kg at the centre and at each corner
4. Stool and post | Fix the stool and the post. Tighten everything. | No wobble; sit on it: no sliding; the weight reads sensibly (your weight within 0.3 kg of a bathroom scale)
5. Foot plates | Screw the 4 plates on the layout in section 1. Run wires to the underside, ring terminals on the screws, shielded cable to the box. | Multimeter: no two plates connect (more than 1 MΩ dry); each plate connects to its wire
6. Handle and hand strips | Fix the bar to the post. Wrap and screw the 4 strips (OUT strips toward the fingers, IN strips toward the wrist). Fit the finger clip near the post. | Strips do not touch each other; no metal touches the post or screws
7. Electronics box | Screw the box under the seat. Mount ESP32, HX711, impedance board (after its phantom test), battery. | Nothing loose; all grounds joined at one point
8. Cables | Route sense cables away from current cables and from the speaker and SIM800L. Clip along the post. Leave slack at the plate (the cells must be free). | Cables do not pull on any load cell: weight reads the same with cables moved
9. Panel | Fix the 3 LEDs, 3 buttons and speaker to the panel box on the post top. | Each LED lights, each button prints
10. Power-up | Battery only, laptop connected over USB. Run the readings. | Weight, pulse, impedance phantom, buttons all show on the laptop

## 5. Tests before a person uses it

Mechanical: sit and stand 10 times: no creak, slide or lift. Total load should not exceed the cells' rating (200 kg for four 50 kg cells).
Weight: same weight within 0.3 kg after stepping on and off 5 times; same reading when you sit slightly left or right. Electrical safety: battery only; dry feet only at first; phantom test passed first (build guide v3, section 5); stop at any tingle.
Edge cases to try: a heavy bag (guest weight), wet feet, one heel lifted, a hand off the grip, unplug one electrode: the laptop should say "no reading" and never a wrong number.

## 6. Common problems

Problem | Likely cause | Fix
Weight drifts or jumps | Cable pulling on a cell; stool touching the floor; loose bolt | Re-route slack; check clearance; tighten
One corner reads backwards | Cell wired the wrong way | Swap that cell's wires
Weight changes when you lean on the handle | Something touches the floor or a wall | Everything touched must stand on the plate only
Impedance reading unstable | Dirty or dry plates; cable noise; loose ring terminal | Clean with alcohol; shorten and shield; re-tighten
Metal plates tarnish | Not stainless | Replace with SS 304

## 7. Not verified

All dimensions, the load-cell mounting, the 8 cm plate gap and the wooden post are my proposals. The load cells' exact type and mounting depend on what you buy. Nothing here has been built.
