aadityaa0523/HridayMitra/source_code/benchmark/leaderboard.csv

split | system | events | sensitivity | specificity | median_lead_days | false_alerts_per_patient_month | sensitivity_ci | specificity_ci | median_lead_days_ci | false_alerts_per_patient_month_ci
test | Weight rule (SCALE-HF, >=2 kg / 2-3 days) | 35 | 0.4 | 0.976 | 2.0 | 0.5337 | 0.25-0.57 | 0.96-0.99 | 1.00-4.00 | 0.36-0.72
test | Weight trend MACD (Gyllensten) | 35 | 0.2286 | 0.9447 | 2.0 | 0.2163 | 0.09-0.38 | 0.91-0.97 | 2.00-4.00 | 0.12-0.33
test | Logistic regression only (ML) | 35 | 0.8 | 0.988 | 2.5 | 0.1154 | 0.65-0.91 | 0.98-1.00 | 2.00-3.00 | 0.04-0.21
test | HridayMitra rules engine v3 (T 7.0) | 35 | 0.6571 | 0.987 | 3.0 | 0.0577 | 0.49-0.81 | 0.97-1.00 | 1.00-3.00 | 0.01-0.11
test | HridayMitra hybrid (rules propose, ML confirms) | 35 | 0.8571 | 0.9788 | 3.0 | 0.1875 | 0.73-0.95 | 0.96-0.99 | 2.00-4.00 | 0.08-0.30
external | Weight rule (SCALE-HF, >=2 kg / 2-3 days) | 100 | 0.31 | 0.9839 | 2.0 | 0.3758 | 0.22-0.41 | 0.98-0.98 | 1.00-2.00 | 0.36-0.39
external | Weight trend MACD (Gyllensten) | 100 | 0.2 | 0.953 | 3.0 | 0.2061 | 0.13-0.28 | 0.95-0.96 | 2.00-5.00 | 0.19-0.22
external | Logistic regression only (ML) | 100 | 0.81 | 0.9921 | 2.0 | 0.0832 | 0.73-0.89 | 0.99-0.99 | 2.00-3.00 | 0.08-0.09
external | HridayMitra rules engine v3 (T 7.0) | 100 | 0.72 | 0.9899 | 2.0 | 0.0557 | 0.63-0.80 | 0.99-0.99 | 2.00-3.00 | 0.05-0.06
external | HridayMitra hybrid (rules propose, ML confirms) | 100 | 0.86 | 0.9899 | 3.0 | 0.0872 | 0.79-0.93 | 0.99-0.99 | 2.00-3.00 | 0.08-0.09
stress | Weight rule (SCALE-HF, >=2 kg / 2-3 days) | 35 | 0.4 | 0.976 | 2.0 | 0.5337 | 0.25-0.57 | 0.96-0.99 | 1.00-4.00 | 0.36-0.72
stress | Weight trend MACD (Gyllensten) | 35 | 0.2286 | 0.9447 | 2.0 | 0.2163 | 0.09-0.38 | 0.91-0.97 | 2.00-4.00 | 0.12-0.33
stress | Logistic regression only (ML) | 35 | 0.7714 | 0.988 | 2.0 | 0.1154 | 0.61-0.89 | 0.98-1.00 | 2.00-3.00 | 0.04-0.21
stress | HridayMitra rules engine v3 (T 7.0) | 35 | 0.6286 | 0.987 | 2.5 | 0.0577 | 0.46-0.78 | 0.97-1.00 | 1.00-3.00 | 0.01-0.11
stress | HridayMitra hybrid (rules propose, ML confirms) | 35 | 0.8571 | 0.9788 | 3.0 | 0.1875 | 0.73-0.95 | 0.96-0.99 | 2.00-4.00 | 0.08-0.30
