aadityaa0523/HridayMitra/source_code/data/processed/measurement_error_model.csv

noise_lsb | contact_ohm | z_true | bias_pct | sd_pct | sd_pct_median3 | fluid_resolution_pct_pts_median3
2 | 100 | 603.49 | -0.016 | 0.515 | 0.342 | 0.39
2 | 1000 | 603.49 | -0.142 | 0.488 | 0.304 | 0.35
2 | 3000 | 603.49 | -0.221 | 0.501 | 0.365 | 0.42
2 | 10000 | 603.49 | -0.331 | 0.488 | 0.327 | 0.38
4 | 100 | 603.49 | -0.015 | 0.495 | 0.328 | 0.38
4 | 1000 | 603.49 | -0.143 | 0.532 | 0.351 | 0.4
4 | 3000 | 603.49 | -0.253 | 0.512 | 0.354 | 0.41
4 | 10000 | 603.49 | -0.298 | 0.505 | 0.363 | 0.42
8 | 100 | 603.49 | -0.061 | 0.483 | 0.336 | 0.39
8 | 1000 | 603.49 | -0.099 | 0.49 | 0.297 | 0.34
8 | 3000 | 603.49 | -0.224 | 0.497 | 0.315 | 0.36
8 | 10000 | 603.49 | -0.337 | 0.558 | 0.377 | 0.43
