aadityaa0523/HridayMitra/source_code/data/processed/measurement_error_model.png

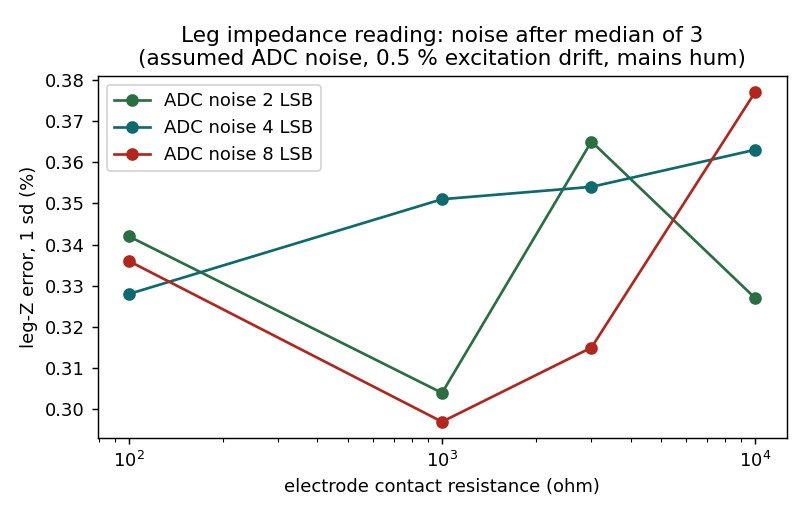
source_code/data/processed/measurement_error_model.png
