aadityaa0523/HridayMitra/source_code/hardware/kicad/hridaymitra_schematic.pdf

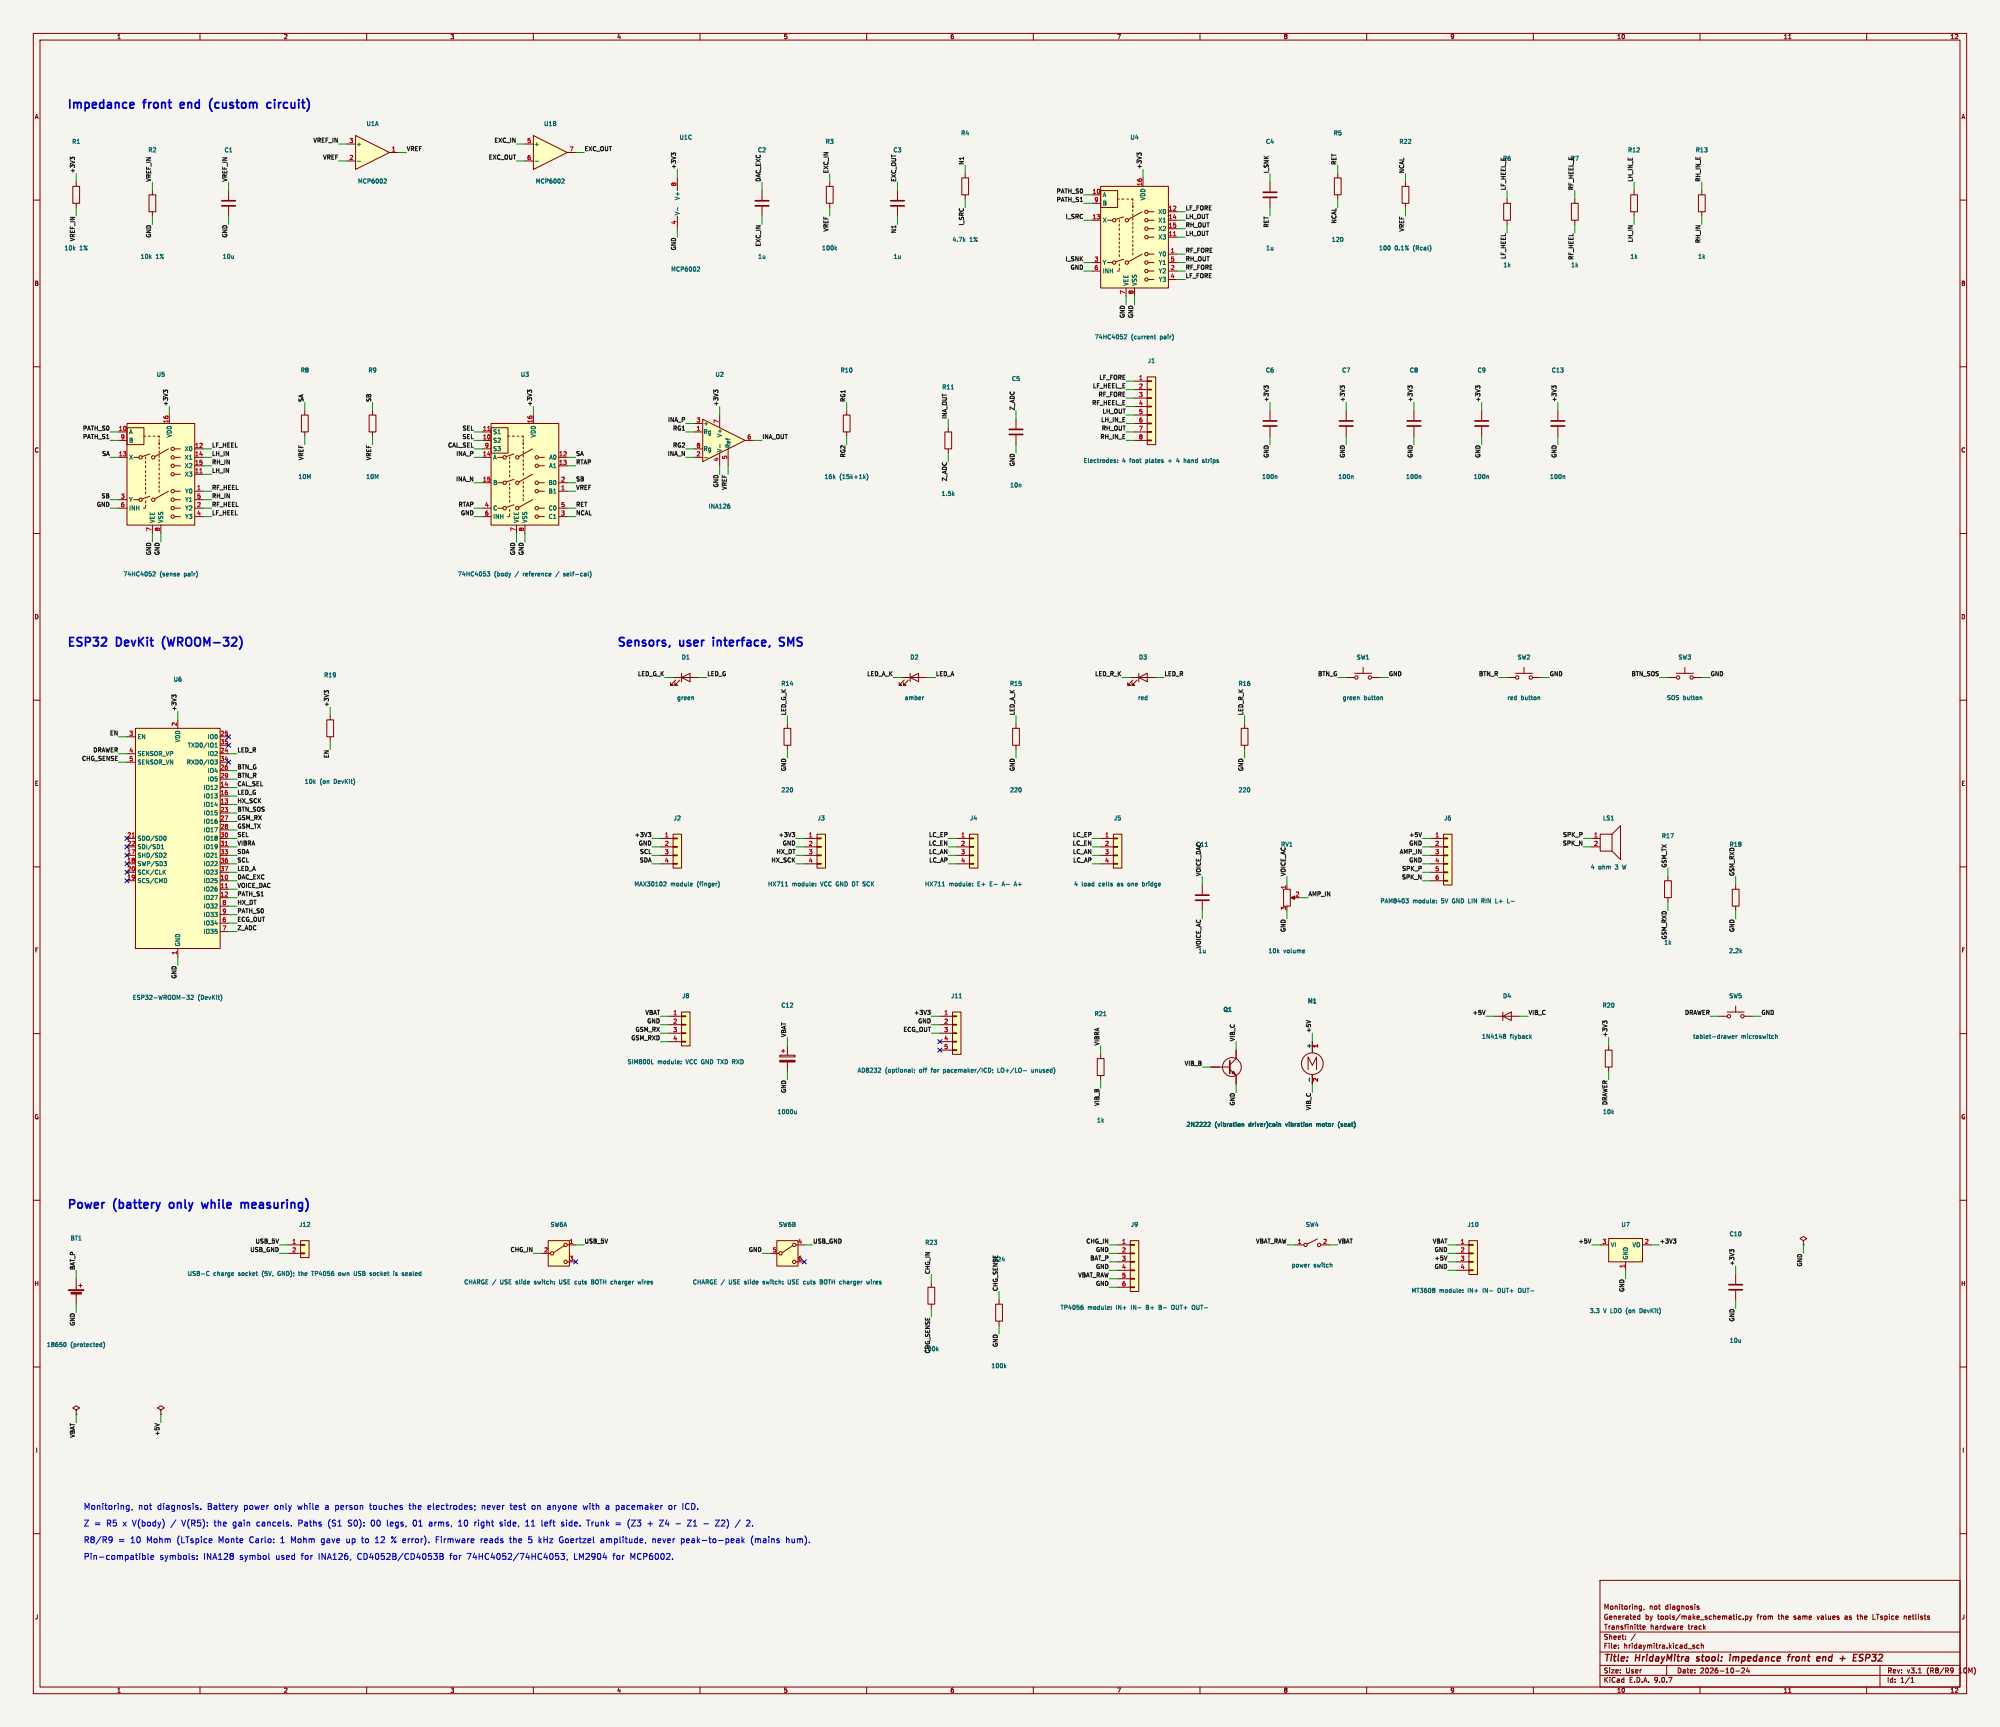
[picture p51: page 1]

Impedance front end (custom circuit)

J3 HX711 module: VCC GND DT SCK

J6 PAM8403 module: 5V GND LIN RIN L+ L- 1 3

4 load cells as one bridge

J8 SIM800L module: VCC GND TXD RXD

Power (battery only while measuring)

3 SW6A CHARGE / USE slide switch: USE cuts BOTH charger wires

Z = R5 x V(body) / V(R5): the gain cancels. Paths (S1 S0): 00 legs, 01 arms, 10 right side, 11 left side. Trunk = (Z3 + Z4 - Z1 - Z2) / 2.
