aadityaa0523/HridayMitra/source_code/docs/hardware/HM-HW-002_schematics.pdf

# Schematic set HM-HW-002: contents

Sheet 1 | Index and conventions
Sheet 2 | Analog front end (custom part)
Sheet 3 | ESP32 and peripherals
Sheet 4 | Power and CHARGE / USE isolation

### Conventions

Signals flow left to right. Net flags (arrow boxes) are global labels: the same name on any sheet is one net.

Power nets: +3V3 (blue), +5V (orange), VBAT 3.0-4.2 V (red), VREF 1.65 V (violet), GND (grey).

Values match the KiCad project hardware/kicad/ (ERC 0, netlist path check) and the LTspice netlists in sim/circuit/.

Patient side = applied part, IEC 60601-1 type BF. Battery only while a person touches the electrodes (SW6 on USE).

Never on anyone with a pacemaker or ICD (weight-only mode). Monitoring, not diagnosis.

Related documents: HM-HW-001 block diagram · HM-HW-003 power budget · HM-HW-004 PCB · HM-HW-005 BOM · HM-HW-006 verification.

### Revision history

A | 2026-10-25 | first release: 8-electrode AFE, 3-frequency spectroscopy, Rcal self-calibration, CHARGE/USE isolation

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
D | D
C | C
B | B
A | A

HridayMitra stool: Index and conventions

Doc HM-HW-002 | Rev A | 2026-10-25 | Size A3
Sheet 1 / 4 | Checked: KiCad ERC 0 · LTspice · firmware emulator

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

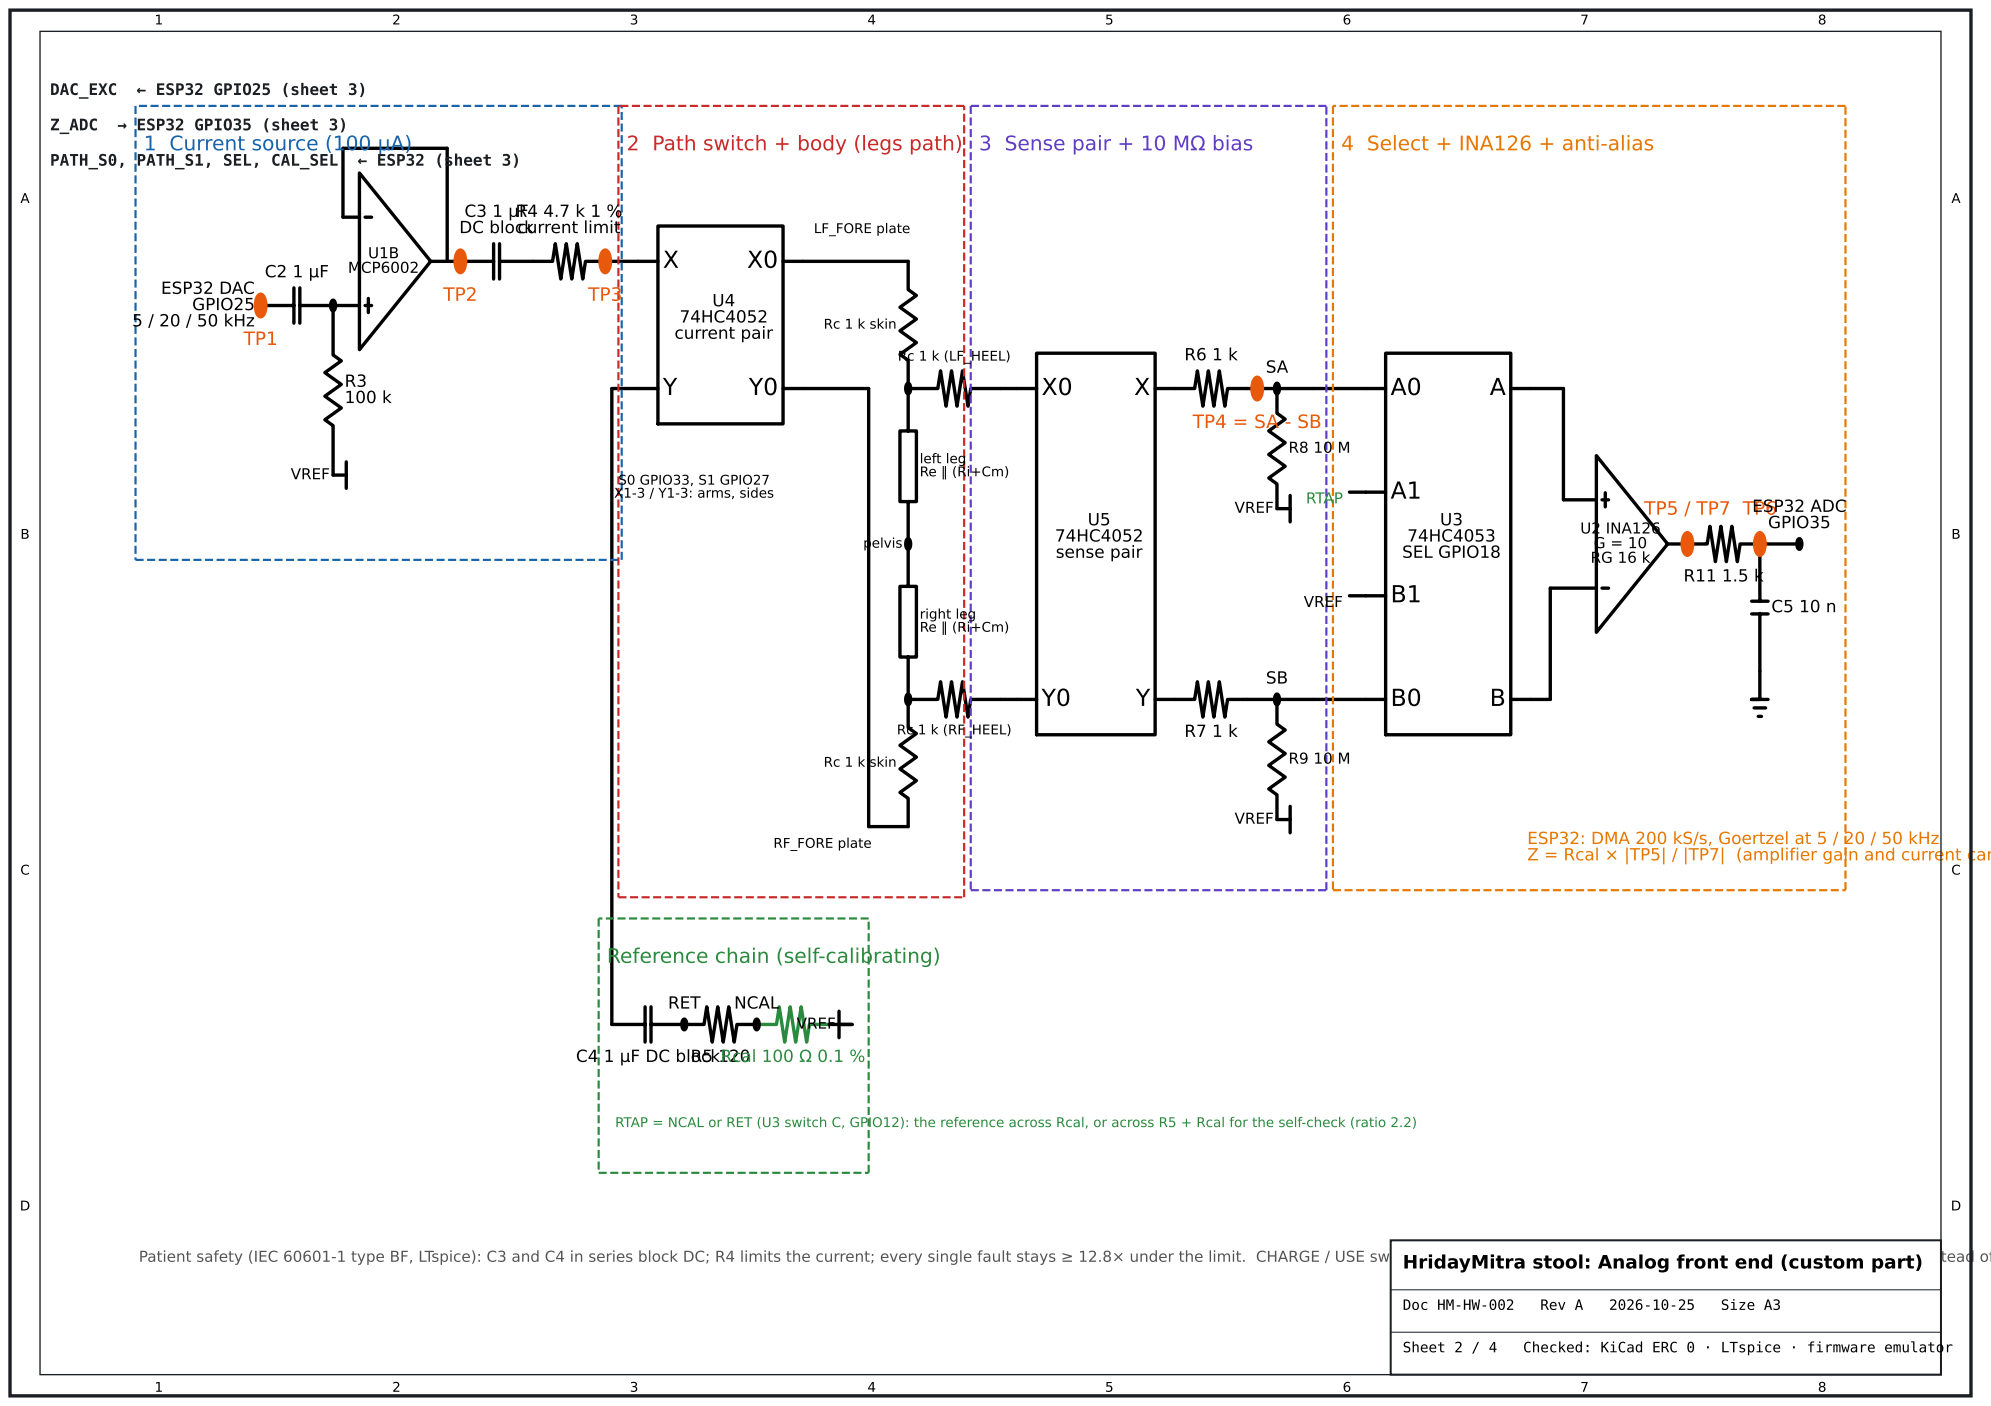
[picture p52: page 2]

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

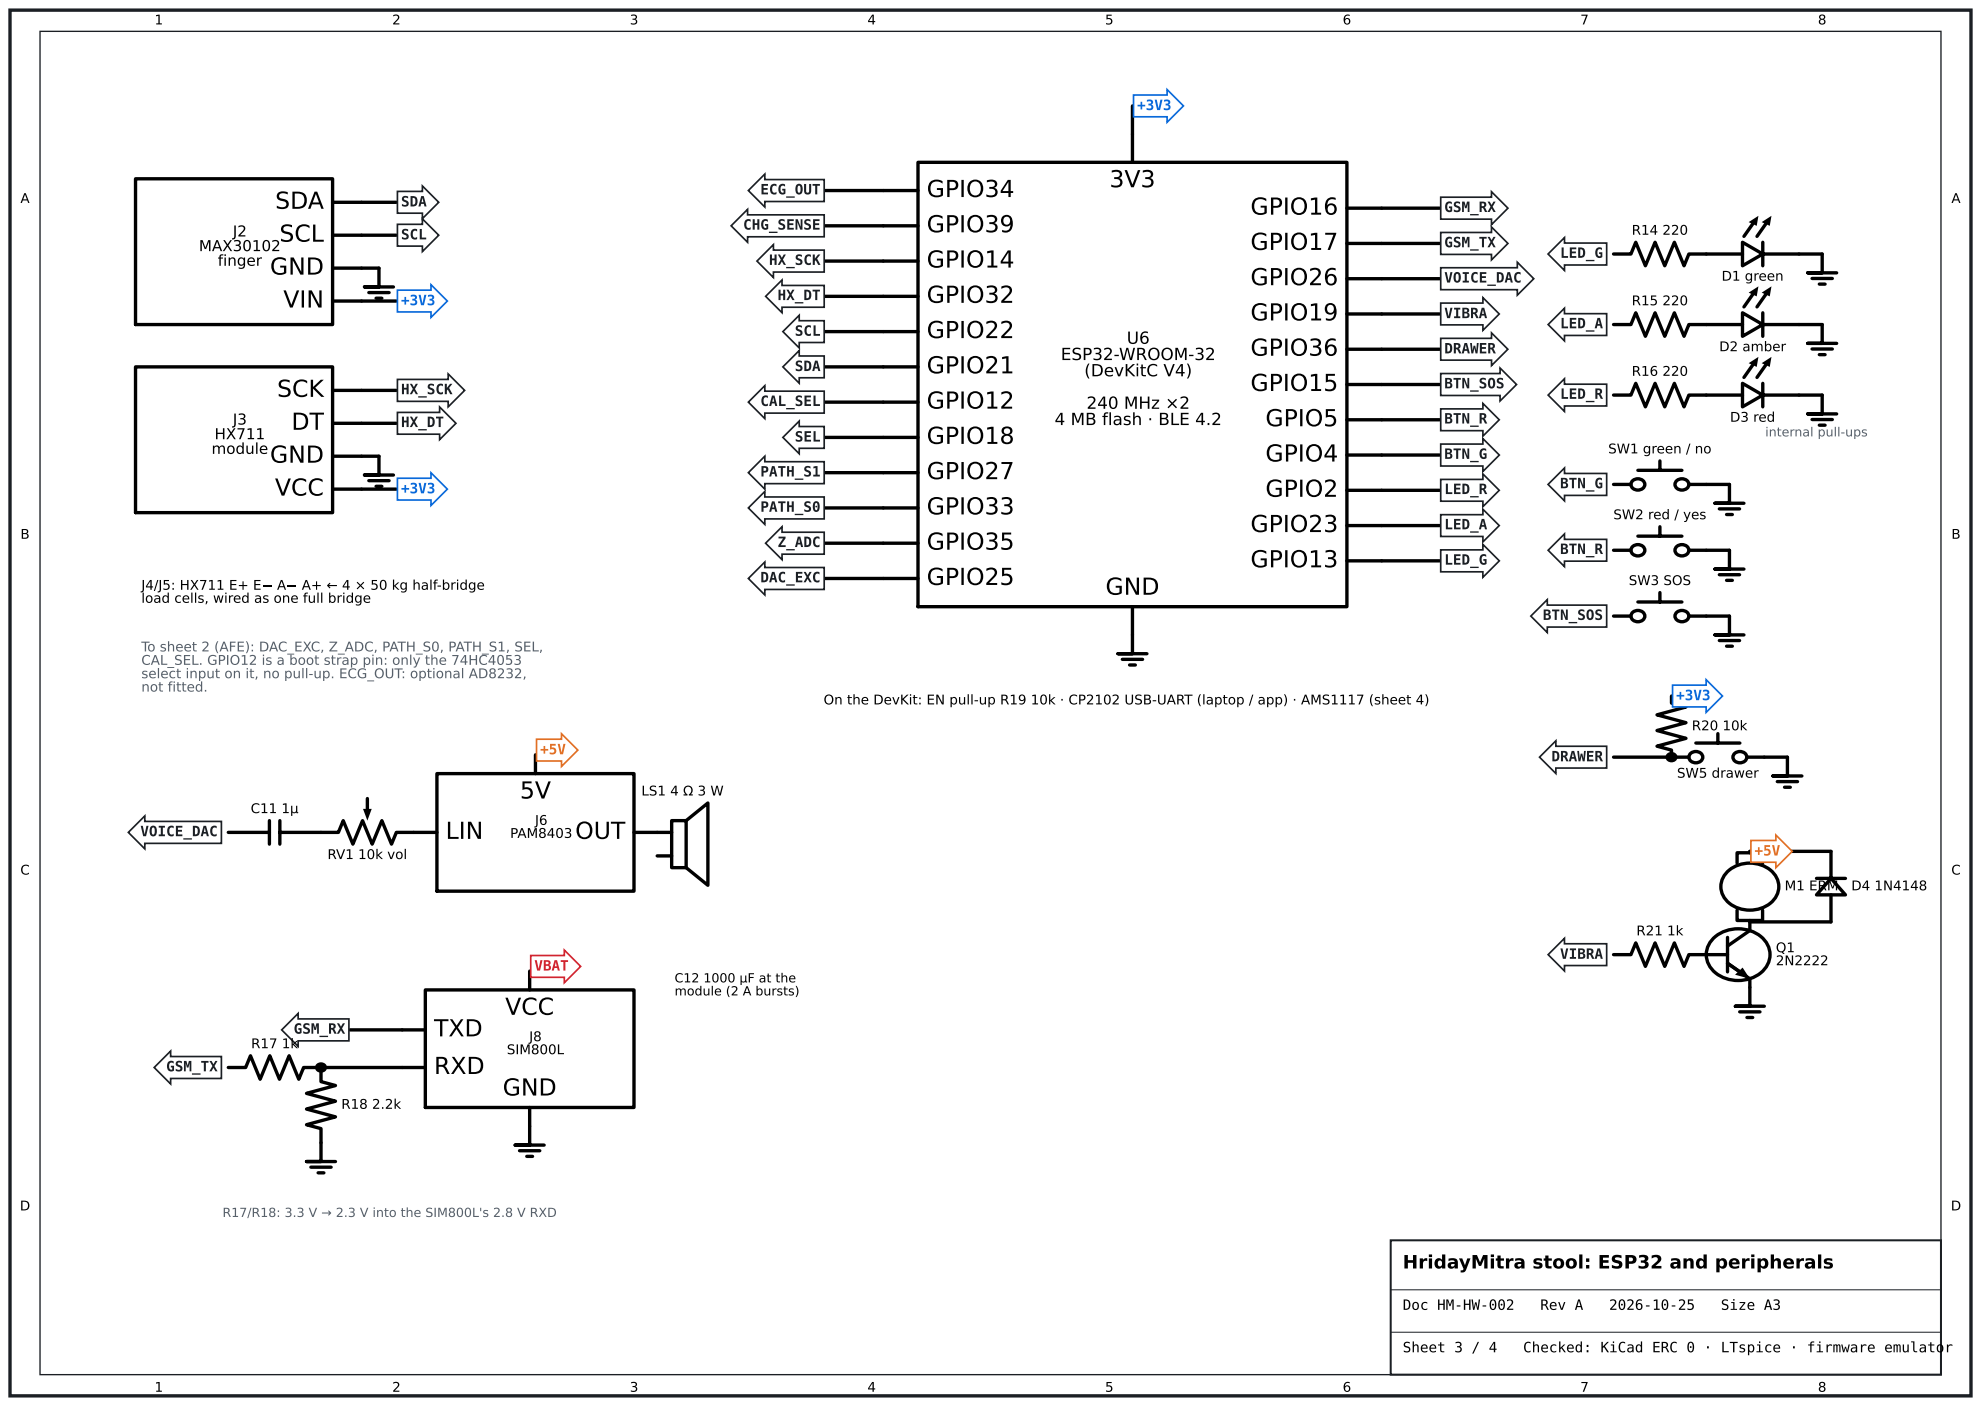
[picture p53: page 3]

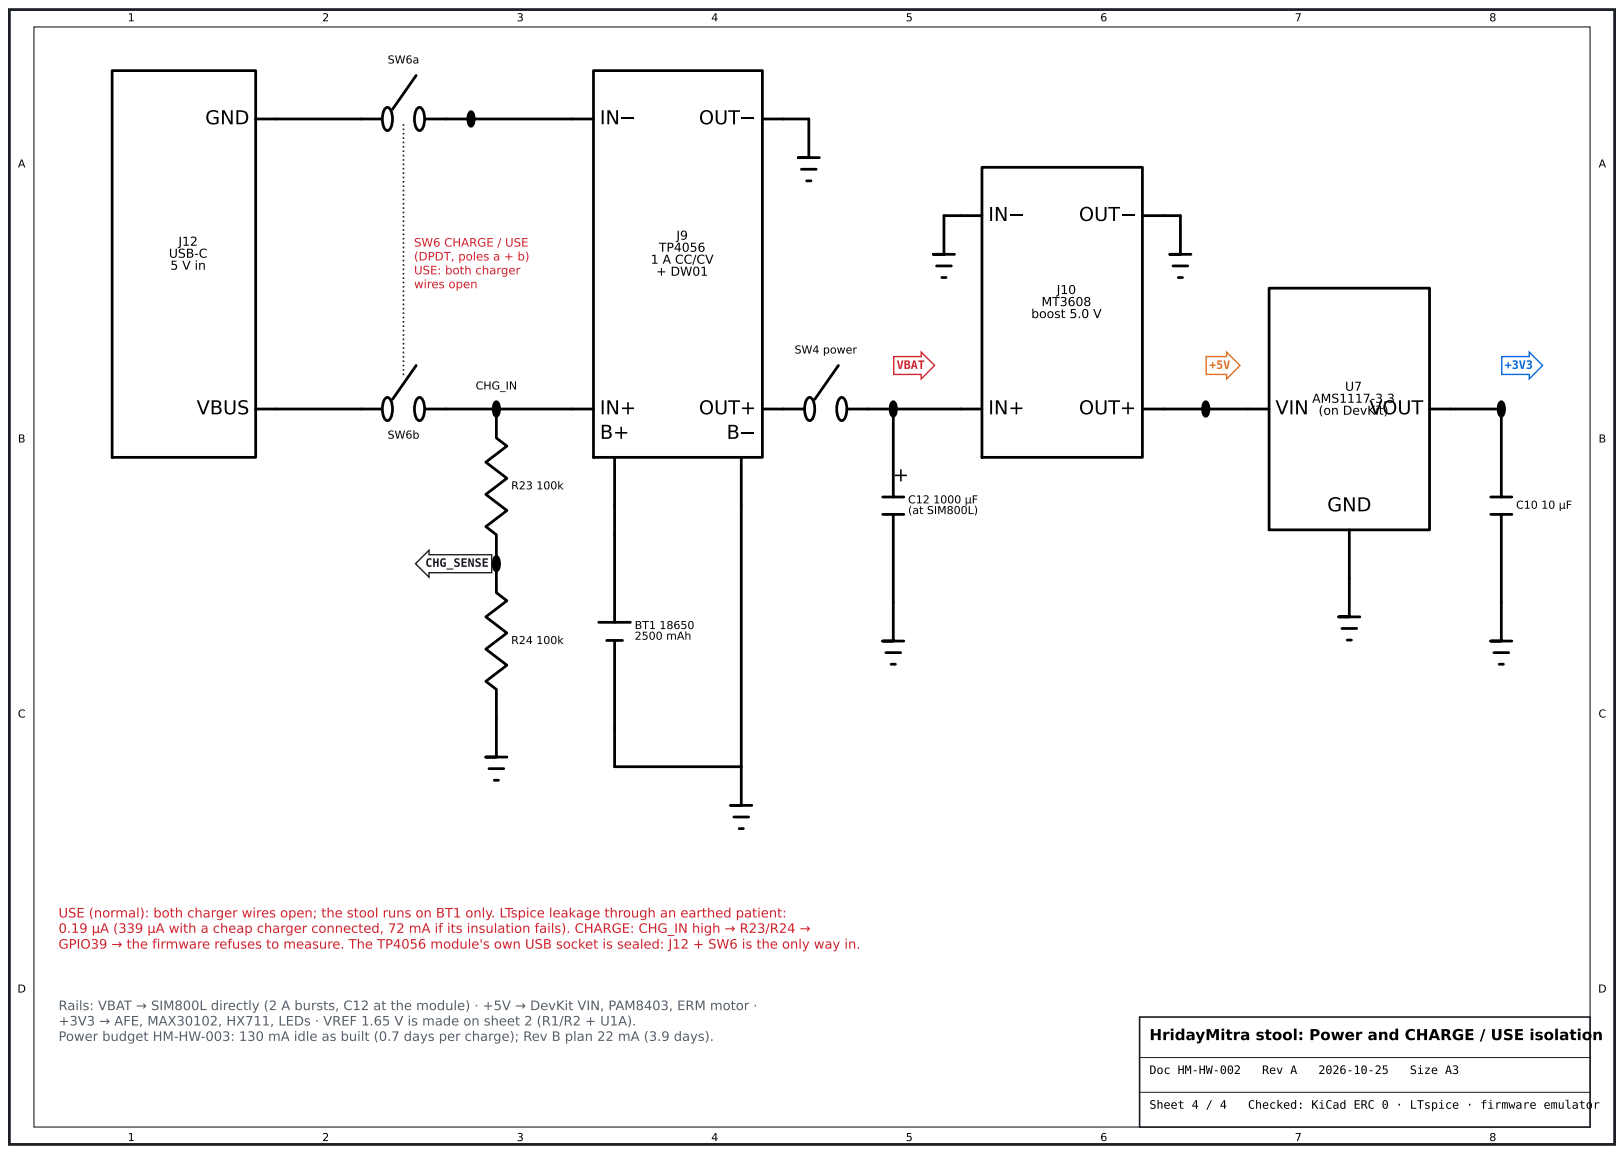
[picture p54: page 4]

USE (normal): both charger wires open; the stool runs on BT1 only. LTspice leakage through an earthed patient:

Power budget HM-HW-003: 130 mA idle as built (0.7 days per charge); Rev B plan 22 mA (3.9 days).

HridayMitra stool: Power and CHARGE / USE isolation
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
