aadityaa0523/HridayMitra/source_code/docs/hardware/HM-HW-001_block_diagram.pdf

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

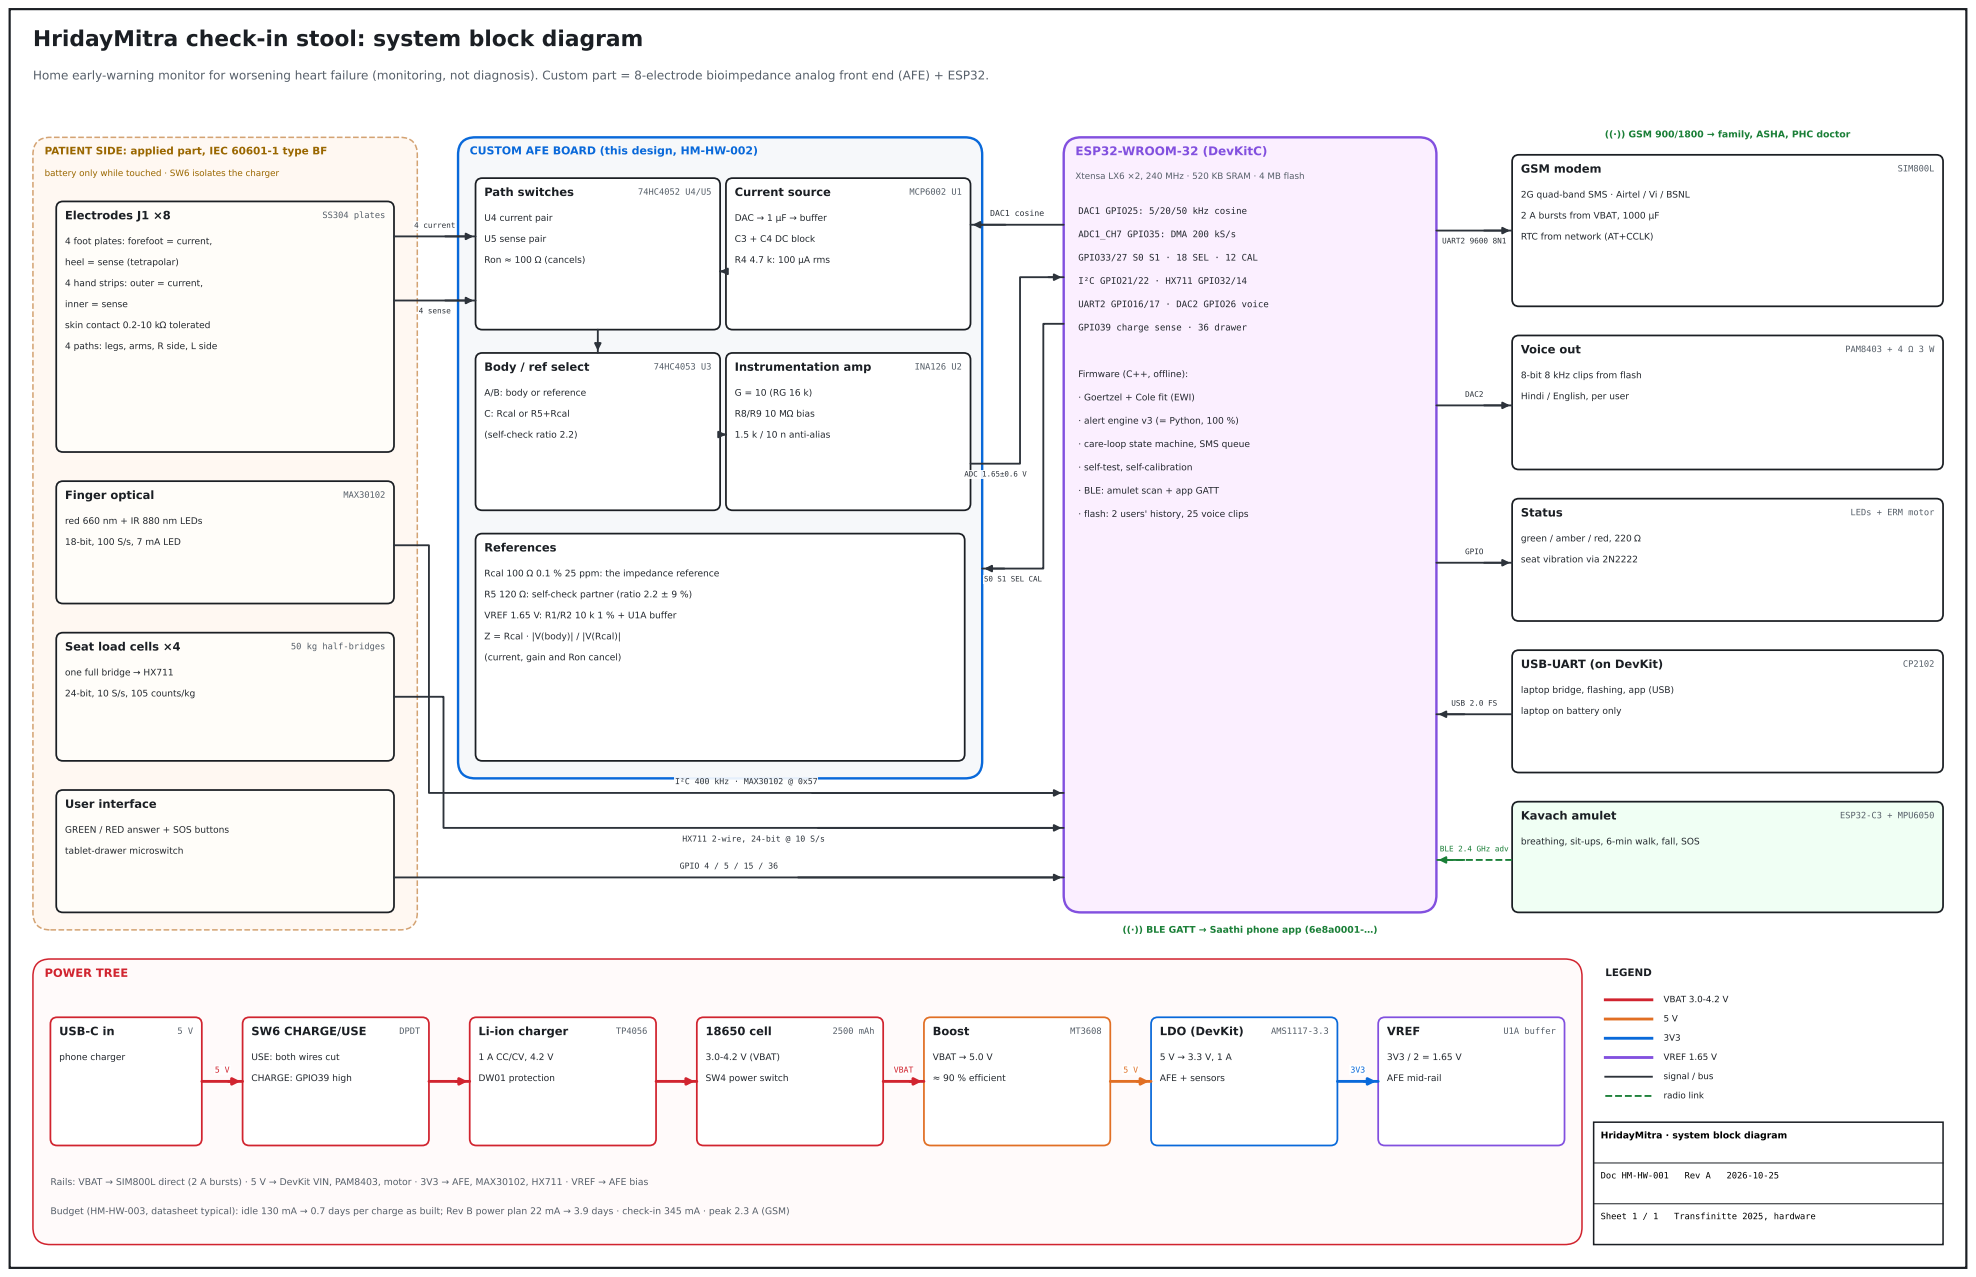
[picture p55: page 1]
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
