aadityaa0523/HridayMitra/source_code/sim/circuit/mc_bias_10M.cir

* ===== HridayMitra: MC bias 10M =====

.param f=5000 path=1 fx=1
.param fl={fx} ft={fx}
V1 vcc 0 3.3
R1 vcc vrefin 10k
R2 vrefin 0 10k
C1 vrefin 0 10u
Bu1a vref 0 V=limit(V(vrefin),0.05,3.25)
Vdac dac 0 SIN(1.65 {amp} {f})
C2 dac excin {c2}
R3 excin vref {r3}
Bu1b excout 0 V=limit(V(excin),0.05,3.25)
C3 excout n1 {c3}
R4 n1 injP {r4}
C4 injN ret {c4}
R5 ret vref {r5}
* --- body: arms to shoulder node SH, trunk SH-PV, legs to pelvis node PV (Cole: Re || Ri+Cm) ---
ReLH LH SH {330*sz}
RiLH LH mLH {750*sz}
CmLH mLH SH {2.9e-09/sz}
ReRH RH SH {330*sz}
RiRH RH mRH {750*sz}
CmRH mRH SH {2.9e-09/sz}
ReLF LF PV {290/fl*sz}
RiLF LF mLF {650*sz}
CmLF mLF PV {3.39e-09/sz}
ReRF RF PV {290/fl*sz}
RiRF RF mRF {650*sz}
CmRF mRF PV {3.39e-09/sz}
ReT SH PV {28/ft*sz}
RiT SH mT {60*sz}
CmT mT PV {3e-08/sz}
* --- electrodes: every hand/foot has an inject (i) and a sense (s) plate, each with contact Rc ---
RciLH iLH LH {rciLH}
RcsLH sLH LH {rcsLH}
RciRH iRH RH {rciRH}
RcsRH sRH RH {rcsRH}
RciLF iLF LF {rciLF}
RcsLF sLF LF {rcsLF}
RciRF iRF RF {rciRF}
RcsRF sRF RF {rcsRF}
* --- path mux (74HC4052, Ron 100 ohm): picks inject pair and sense pair ---
.model SW SW(Ron=100 Roff=1G Vt=1.65 Vh=0.1)
Bm1 c1 0 V=if(abs(path-2)<0.5,3.3,0) + if(abs(path-3)<0.5,3.3,0)
Sm1 injP iLH c1 0 SW
Bm2 c2 0 V=if(abs(path-4)<0.5,3.3,0)
Sm2 injP iRH c2 0 SW
Bm3 c3 0 V=if(abs(path-1)<0.5,3.3,0)
Sm3 injP iLF c3 0 SW
Bm4 c4 0 V=if(abs(path-2)<0.5,3.3,0)
Sm4 injN iRH c4 0 SW
Bm5 c5 0 V=if(abs(path-3)<0.5,3.3,0)
Sm5 injN iLF c5 0 SW
Bm6 c6 0 V=if(abs(path-1)<0.5,3.3,0) + if(abs(path-4)<0.5,3.3,0)
Sm6 injN iRF c6 0 SW
Bm7 c7 0 V=if(abs(path-2)<0.5,3.3,0) + if(abs(path-3)<0.5,3.3,0)
Sm7 sraw_p sLH c7 0 SW
Bm8 c8 0 V=if(abs(path-4)<0.5,3.3,0)
Sm8 sraw_p sRH c8 0 SW
Bm9 c9 0 V=if(abs(path-1)<0.5,3.3,0)
Sm9 sraw_p sLF c9 0 SW
Bm10 c10 0 V=if(abs(path-2)<0.5,3.3,0)
Sm10 sraw_n sRH c10 0 SW
Bm11 c11 0 V=if(abs(path-3)<0.5,3.3,0)
Sm11 sraw_n sLF c11 0 SW
Bm12 c12 0 V=if(abs(path-1)<0.5,3.3,0) + if(abs(path-4)<0.5,3.3,0)
Sm12 sraw_n sRF c12 0 SW
* --- sense lines: 1k protection, 1M bias to VREF ---
R6 sraw_p sa {r6}
R7 sraw_n sb {r7}
R8 sa vref {r8}
R9 sb vref {r9}
* --- 74HC4053 selector: selv=0 body, selv=3.3 across R5 ---
Vsel sel 0 PULSE(0 3.3 0.02 1u 1u 0.02 0.1)
Bch chi 0 V=V(sel)
Bcl clo 0 V=3.3-V(sel)
S1 inp sa clo 0 SW
S2 inp ret chi 0 SW
S3 inn sb clo 0 SW
S4 inn vref chi 0 SW
Bina ina 0 V=limit(V(vref)+{gain}*(V(inp)-V(inn))+{gain}*{cmrr}*((V(inp)+V(inn))/2-V(vref)),0.05,3.25)
R11 ina adc {r11}
C5 adc 0 {c5}
Radc adc 0 10Meg
* --- DC definition of floating nodes ---
Rd0 n1 vref 1G
Rd1 injP vref 1G
Rd2 injN vref 1G
Rd3 SH vref 1G
Rd4 PV vref 1G
Rd5 mT vref 1G
Rd6 sraw_p vref 1G
Rd7 sraw_n vref 1G
Rd8 LH vref 1G
Rd9 RH vref 1G
Rd10 LF vref 1G
Rd11 RF vref 1G
Rd12 mLH vref 1G
Rd13 mRH vref 1G
Rd14 mLF vref 1G
Rd15 mRF vref 1G
Rd16 iLH vref 1G
Rd17 iRH vref 1G
Rd18 iLF vref 1G
Rd19 iRF vref 1G
Rd20 sLH vref 1G
Rd21 sRH vref 1G
Rd22 sLF vref 1G
Rd23 sRF vref 1G
.tran 0 0.04 0 5u
.step param fx list 1 1.1
.step param path list 1 2 3 4
.step param run 1 100 1
.meas TRAN vbody PP V(adc) FROM=0.008 TO=0.019
.meas TRAN vsens PP V(adc) FROM=0.028 TO=0.039
.meas TRAN zmeas PARAM 220*vbody/vsens
.save V(adc) I(R4)
.param r3=table(run,1,101251,2,100149,3,103713,4,96316.2,5,95303.5,6,100130,7,99300,8,101352,9,95210.8,10,96972.8,11,98805.8,12,101199,13,102210,14,102604,15,99550.2,16,103734,17,101815,18,98350.8,19,97222,20,103447,21,98771.4,22,99451.9,23,99880.8,24,97696.4,25,101119,26,99032.5,27,101289,28,96729.7,29,103126,30,96350.9,31,99870.3,32,98565.1,33,101958,34,104428,35,101363,36,104501,37,95932,38,103907,39,97803.8,40,99710.9,41,98340.1,42,100195,43,98940.8,44,103639,45,99093.5,46,102782,47,95573,48,100871,49,96278.7,50,102119,51,100217,52,103975,53,102150,54,103703,55,100425,56,95737.7,57,96340,58,102450,59,99215.2,60,96385.8,61,95116.8,62,102712,63,96907,64,99148.6,65,99611.6,66,97300.1,67,100132,68,96721.7,69,97013.6,70,97685.9,71,99872.6,72,101620,73,95760.5,74,104894,75,97807.8,76,97922,77,100315,78,98603.5,79,98882.3,80,103795,81,98674,82,95185.5,83,95927.3,84,98129.7,85,97101.6,86,104336,87,104759,88,99652.7,89,103959,90,104376,91,102741,92,98525.5,93,97886.2,94,101118,95,97914,96,102612,97,95432.8,98,97956.9,99,97370.4,100,97674.5)
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
