aadityaa0523/HridayMitra/source_code/hardware/pcb/hridaymitra_afe.kicad_pcb

## KiCad design source_code/hardware/pcb/hridaymitra_afe.kicad_pcb (2026-10-25)

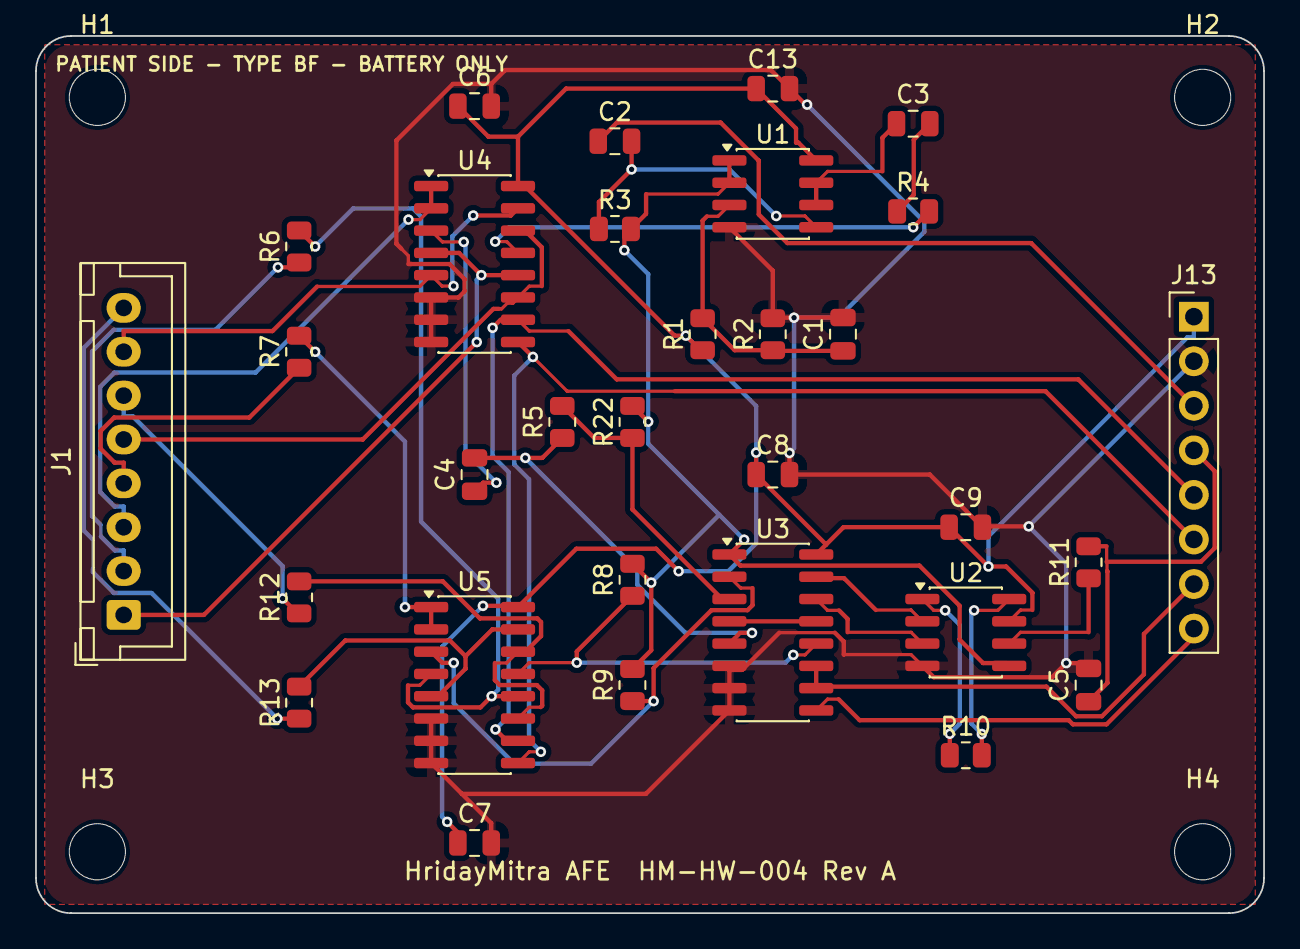
[picture p57: board hridaymitra_afe.kicad_pcb from above]

Board: 2 copper layers, 70.0 x 50.0 mm, 35 parts (0 on the bottom side), 37 nets.

Parts:
C1: 10u; C_0805_2012Metric
C2, C3, C4: 1u; C_0805_2012Metric
C5: 10n; C_0805_2012Metric
C6, C7, C8, C9, C13: 100n; C_0805_2012Metric
H1, H2, H3, H4: MountingHole_3.2mm_M3
J1: Electrodes: 4 foot plate; JST_XH_B8B-XH-A_1x08_P2.50mm_Vertical
J13: to ESP32 DevKit; PinHeader_1x08_P2.54mm_Vertical
R1, R2: 10k 1%; R_0805_2012Metric
R3: 100k; R_0805_2012Metric
R4: 4.7k 1%; R_0805_2012Metric
R5: 120; R_0805_2012Metric
R6, R7, R12, R13: 1k; R_0805_2012Metric
R8, R9: 10M; R_0805_2012Metric
R10: 16k (15k+1k); R_0805_2012Metric
R11: 1.5k; R_0805_2012Metric
R22: 100 0.1% (Rcal); R_0805_2012Metric
U1: MCP6002; SOIC-8_3.9x4.9mm_P1.27mm
U2: INA126; SOIC-8_3.9x4.9mm_P1.27mm
U3: 74HC4053 (body / referen; SOIC-16_3.9x9.9mm_P1.27mm
U4: 74HC4052 (current pair); SOIC-16_3.9x9.9mm_P1.27mm
U5: 74HC4052 (sense pair); SOIC-16_3.9x9.9mm_P1.27mm

Connections:
+3V3: C6.1, C7.1, C8.1, C9.1, C13.1, J13.1, R1.1, U1.8, U2.7, U3.16, U4.16, U5.16
CAL_SEL: J13.8, U3.9
DAC_EXC: C2.1, J13.3
EXC_IN: C2.2, R3.1, U1.5
EXC_OUT: C3.1, U1.6, U1.7
GND: C1.2, C5.2, C6.2, C7.2, C8.2, C9.2, C13.2, J13.2, R2.2, U1.4, U2.4, U3.6, U3.7, U3.8, U4.6, U4.7, U4.8, U5.6, U5.7, U5.8
INA_N: U2.2, U3.15
INA_OUT: R11.1, U2.6
INA_P: U2.3, U3.14
I_SNK: C4.1, U4.3
I_SRC: R4.2, U4.13
LF_FORE: J1.1, U4.4, U4.12
LF_HEEL: R6.2, U5.4, U5.12
LF_HEEL_E: J1.2, R6.1
LH_IN: R12.2, U5.11, U5.14
LH_IN_E: J1.6, R12.1
LH_OUT: J1.5, U4.11, U4.14
N1: C3.2, R4.1
NCAL: R5.2, R22.1, U3.3
PATH_S0: J13.5, U4.10, U5.10
PATH_S1: J13.6, U4.9, U5.9
RET: C4.2, R5.1, U3.5
RF_FORE: J1.3, U4.1, U4.2
RF_HEEL: R7.2, U5.1, U5.2
RF_HEEL_E: J1.4, R7.1
RG1: R10.1, U2.1
RG2: R10.2, U2.8
RH_IN: R13.2, U5.5, U5.15
RH_IN_E: J1.8, R13.1
RH_OUT: J1.7, U4.5, U4.15
RTAP: U3.4, U3.13
SA: R8.1, U3.12, U5.13
SB: R9.1, U3.2, U5.3
SEL: J13.7, U3.10, U3.11
VREF: R3.2, R8.2, R9.2, R22.2, U1.1, U1.2, U2.5, U3.1
VREF_IN: C1.1, R1.2, R2.1, U1.3
Z_ADC: C5.1, J13.4, R11.2
