aadityaa0523/HridayMitra/(commit log)

2026-10-24 HridayMitra: home early warning of worsening heart failure (hackathon prototype)
    Alert engine with frozen thresholds and the four PS measures, synthetic patient
    cohorts, stress/assumption tests, care-loop simulator, LTspice simulations
    (paths, Monte Carlo, hum), KiCad schematic from code, raw-signal module,
    Streamlit demo, docs. Monitoring, not diagnosis.
    [amber_lead_results.csv, assumption_sensitivity.csv, bidmc_hr_validation.csv, calibration_check.csv, careloop_results.csv, cost_simulation.csv, daily_features.csv, hridaymitra.kicad_sch]
2026-10-24 Firmware, offline engine on the ESP32, product features, full flow
    - ESP32 stool firmware (check-in, Goertzel impedance, PPG, SMS care loop) and
    ESP32-C3 amulet firmware (breathing, sit-ups, activity, falls, SOS over BLE);
    both compile with arduino-cli
    - Alert engine ported to C++ (engine_core.h): 100% identical lights to the
    Python engine over 3,231 patient-days (tests/test_engine_parity.py)
    - Product layer: doctor's sick-day plan, coaching tips, two users per stool,
    daily self-test, 11:00 reminder, Sunday ASHA summary, seat vibration,
    tablet drawer, village dashboard, OPD report, ABDM/FHIR export
    - Engine: "no check-in" day holds the light; cold-start "learning" flag
    - Stool brid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
    [amber_lead_results.csv, assumption_sensitivity.csv, careloop_results.csv, cost_simulation.csv, hridaymitra.kicad_sch, leadtime_v2_grid.csv, leadtime_v2_results.csv, ml_comparator.csv]
2026-10-24 Prove the firmware: software-in-the-loop month, 3 firmware bugs fixed
    - tests/sil: the real stool firmware compiled on a laptop against an emulated
    world (ADC body signal, HX711, MAX30102, SIM800L, buttons, BLE, flash);
    a scripted month: 26/26 claims pass; every light equals the Python engine
    - Fixed: user 1's usual weight started at 0 kg; a red day after an earlier
    red could pass with no SMS; user 1 not recognised once a second user was
    enrolled; replies arriving during another modem command were lost
    - Parallel BIDMC prefetch; docs, report and deck updated
    [hridaymitra.kicad_sch]
2026-10-24 Wokwi: virtual patient, MAX30102 and SIM800L-with-phone-screen custom chips; Wokwi build mode
    [hridaymitra.kicad_sch]
2026-10-24 Wokwi: body chip runs its 5 kHz signal only while the excitation pin is high (full-speed simulation)
2026-10-24 Wokwi: patient digital twin (animated current path, fluid fill) and stool monitor chips; product layout
2026-10-24 BIDMC: all 15 real ECG records (median HR error 0.15 bpm; fails on noisy chf12); report and deck rebuilt
    [bidmc_hr_validation.csv]
2026-10-24 Add spectroscopy (C1), self-calibrating reference (C2), patient-safety analysis (C3)
    - 5/20/50 kHz leg spectroscopy with closed-form Cole fit (EWI); engine v3 frozen at T=7.0
    - Rcal 0.1% reference on the spare 74HC4053 switch, ratio check + service SMS
    - IEC 60601-1 type-BF single-fault simulation: all pass, >=12.8x margin
    - Firmware DMA ADC, SIL emulator 31/31, schematic, guides, docs regenerated
    [amber_lead_results.csv, assumption_sensitivity.csv, careloop_results.csv, cost_simulation.csv, daily_features.csv, hridaymitra.kicad_sch, hum_results.csv, ml_comparator.csv]
2026-10-25 Add 6-minute walk test to the amulet
    - walk_core.h: steps from the walking rhythm (autocorrelation, 5 s windows, 20 Hz); best 6 minutes of the last 24 h over BLE
    - Stool asks for the walk on Sundays; weekly ASHA SMS gives steps, ~metres and last week (not in the alert score)
    - Synthetic accuracy: snug cord within 2.7%; 0 false steps sitting, fidgeting, auto-rickshaw, turning in bed
    - C++ = Python test, SIL check 32/32, Wokwi and voice clips regenerated
    [hridaymitra.kicad_sch, walk_accuracy.csv]
2026-10-25 Add CHARGE / USE safety switch (charger isolation)
    - SW6 DPDT cuts both USB charger wires in USE; GPIO39 senses CHARGE and the firmware refuses to measure
    - charger_leakage.py: earthed patient leakage 339 uA (cheap charger) / 72 mA (failed) without it, 0.19 uA in USE
    - Schematic with netlist checks (ERC 0), parts list +Rs 50 (Rs 4,820, Rs 180 under the limit), guides and PDFs
    - Firmware emulator check: no excitation while on CHARGE (33/33); voice clip added
    [charger_leakage_results.csv, cost_simulation.csv, hridaymitra.kicad_sch]
2026-10-25 Merge the HridayMitra Saathi app; port its stool link onto current firmware
    - app/ (PWA, 10 languages, voice, family/ASHA/doctor) without node_modules, dist or voice models
    - App engine ported to v3 (leg_ewi, T 7.0/6.0), vectors regenerated from Python; 109 tests incl. parsing every SIL check-in
    - app_link.h on current firmware: BLE GATT + USB, date/event_id/plate + leg_ewi, ref_ratio, walk6_steps; Wokwi USB-only
    - SIL: BLE server and queue mocks, 3 app-link checks (36/36); fix 0 s stand-up time reported as a reading
    - Spectroscopy emulator bound corrected to 0.6% (worst 0.51%)
    [hridaymitra.kicad_sch]
2026-10-25 Hybrid engine, open benchmark v2, published calibration, lifted-foot retry, demo video
    - engine/hybrid.py: rules propose, a dev-trained logistic model confirms; 86% caught on test/external/stress within budget
    - benchmark/: fixed splits (sha256), public scorer with bootstrap ranges, 5 baselines, leaderboard, datasheet
    - engine/calibrate_published.py: FAST and SCALE-HF 1 weight rules reproduce published sensitivity and alert rates
    - Firmware: names the lifted foot from failed paths and re-measures; red SMS always keeps "call 108" within 160 chars
    - docs/demo video: real firmware month driving real Wokwi chip screens + KiCad front end with live parts highlighted
    - Wokwi monitor chip threshold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
    [calibration_published.csv, hridaymitra.kicad_sch, hridaymitra_hybrid_test.csv, hridaymitra_rules_engine_v3_test.csv, leaderboard.csv, logistic_regression_only_test.csv, weight_rule_test.csv, weight_trend_macd_test.csv]
2026-10-25 Add system architecture and wired front-end schematic sheet with LTspice test points
2026-10-25 Add reference-design block diagram (HM-HW-001) and power budget (HM-HW-003)
    Power budget found the as-built idle draw (130 mA, 0.7 days per charge) and adds a Rev B plan (22 mA, 3.9 days).
    [HM-HW-003_power_budget.csv]
2026-10-25 Add production-style schematic set HM-HW-002 (index, AFE, ESP32 + peripherals, power + CHARGE/USE) with title blocks
2026-10-25 Add one-page user journey storyboard (HM-UX-001) built on real engine output for test patient P0189
2026-10-25 Storyboard: chair + weighing platform + lap sensor bar design, 2026, continuous chart, readable weekly SMS
2026-10-25 Report: chair + platform + hand bar design, hybrid engine, trial calibration, hardware sheets, storyboard (2 pages)
2026-10-25 Parts list for the chair + weighing platform + hand sensor bar build (Rs 3,917-4,890, under Rs 5,000); subtotals recomputed
    [cost_simulation.csv]
2026-10-25 README: rewrite from a full repo review; current chair design, cost, results table, app and troubleshooting
    Claude-Session: https://claude.ai/code/session_01R1mtK3pYeBVXYBpNJqC7vP
2026-10-25 Real-data check on BIDMC PPG and Respiration (53 patients): stool pulse code and amulet breathing method
    [bidmc_ppg_validation.csv]
2026-10-25 Regenerated Wokwi firmware copy (sit-to-stand) and KiCad outputs
    [hridaymitra.kicad_sch]
2026-10-25 Routed AFE PCB (HM-HW-004) and README: what's new, 90-second use, robustness to assumptions
    [hridaymitra_afe-B_Courtyard.gbr, hridaymitra_afe-B_Cu.gbl, hridaymitra_afe-B_Fab.gbr, hridaymitra_afe-B_Mask.gbs, hridaymitra_afe-B_Paste.gbp, hridaymitra_afe-B_Silkscreen.gbo, hridaymitra_afe-Edge_Cuts.gm1, hridaymitra_afe-F_Courtyard.gbr]
2026-10-25 Judge-facing folders: hardware, software/analytics, data, testing, simulation
    [assumption_sensitivity.csv, sample_two_patients.csv, stress_and_ablation.csv]
2026-10-25 03_Data: full 200-patient synthetic dataset and external set labels
    [daily_features.csv, labels.csv, patients.csv, truth_daily.csv]
2026-10-25 03_Data: day-by-day alerts.csv for every patient-day and a table of the scripts that build and analyse the data
    [alerts.csv]
2026-10-25 03_Data: all datasets in numbered folders (main, external, two stress families, PhysioNet), stress sets exported exactly as tested
    [10_guest_days.csv, 15_wet_feet_days.csv, 30_of_days_missing.csv, 50_of_days_missing.csv, alerts.csv, amulet_worn_only_half_the_time.csv, clean_before_stress.csv, daily_features.csv]
2026-10-25 Group all code into source_code/ so judge folders lead the repo; prototype photo beside the concept image; Saathi app screenshots
    Python tests: 67 passed from source_code/.
    [HM-HW-003_power_budget.csv, amber_lead_results.csv, assumption_sensitivity.csv, bidmc_hr_validation.csv, bidmc_ppg_validation.csv, calibration_check.csv, calibration_published.csv, careloop_results.csv]
